roykollensvendsen/garage-door/docs/openers/lm100evf.md

<!-- SPDX-License-Identifier: GPL-3.0-or-later -->
<!-- Generated by scripts/openers.py from hardware/openers/. Do not edit. -->

# LiftMaster LM100EVF

**Status:** Expected to work, not tried yet.

| | |
|---|---|
| Brand and model | LiftMaster LM100EVF |
| Also sold as | none known |
| Region | EU |
| Manual | Assembly and operating instructions, LM60EVF/LM80EVF/LM100EVF/LM130EVF, document 114A4C095B ([download](https://ismartgate.com/manuals/Chamberlain_LM80EVF_manual.pdf)) |
| Push-button terminals | **1 and 2** (manual PDF p. 269, fig. 19-20 (one manual and terminal block for all four models)) |
| Voltage across them, open | not measured yet |
| Reported by | nobody yet |
| A build | none yet |

## Checked on a real opener

- Nothing yet.

## Leave alone

- The wire bridge on terminals 4 and 5 (manual PDF p. 22, section 26 A).

## Notes

Shares the LM80EVF's manual and terminal block, so the same wiring is expected to work. Nobody has tried it yet: if you do, change the status and add your name.

Source: [`hardware/openers/lm100evf.yaml`](https://github.com/roykollensvendsen/garage-door/blob/main/hardware/openers/lm100evf.yaml).
To correct it, edit that file; see [Add your opener](../compatibility.md#add-your-opener).
