roykollensvendsen/garage-door/docs/compatibility.md

<!-- SPDX-License-Identifier: GPL-3.0-or-later -->
<!-- Generated by scripts/openers.py from hardware/openers/. Do not edit. -->

# Does it work with your opener?

The controller needs one thing from an opener: a **wall push-button input**
that starts, stops and reverses the door when two terminals are briefly joined.
Most garage door openers have one. These are the models we know about.

| Opener | Region | Push-button terminals | Status |
|---|---|---|---|
| [LiftMaster LM100EVF](openers/lm100evf.md) | EU | 1 and 2 | Expected to work, not tried yet |
| [LiftMaster LM130EVF](openers/lm130evf.md) | EU | 1 and 2 | Expected to work, not tried yet |
| [LiftMaster LM60EVF](openers/lm60evf.md) | EU | 1 and 2 | Expected to work, not tried yet |
| [LiftMaster LM80EVF](openers/lm80evf.md) | EU | 1 and 2 | Works: built and used on a real door |

"Expected to work" means the manual shows the same push-button input, but
nobody has built the controller for that model yet. Be the first, and tell us.

## Add your opener

Adding your opener is the easiest way to contribute, and the most useful.

1. Find your opener's manual and the page that shows the wall push-button
   terminals.
2. Copy [`hardware/openers/_template.yaml`](https://github.com/roykollensvendsen/garage-door/blob/main/hardware/openers/_template.yaml)
   to `hardware/openers/<model>.yaml` and fill it in. Cite a manual page for
   every terminal, and never copy the manual's text.
3. Run `just docs` to see your page, and open a pull request.

Not sure? [Open an "add my opener" issue](https://github.com/roykollensvendsen/garage-door/issues/new?template=add-opener-model.yml)
with the model and a photo of the terminal block, and we will help. A coding
agent can do it with the project skill `add-opener-model`.
