roykollensvendsen/garage-door/docs/assets/social-preview.png

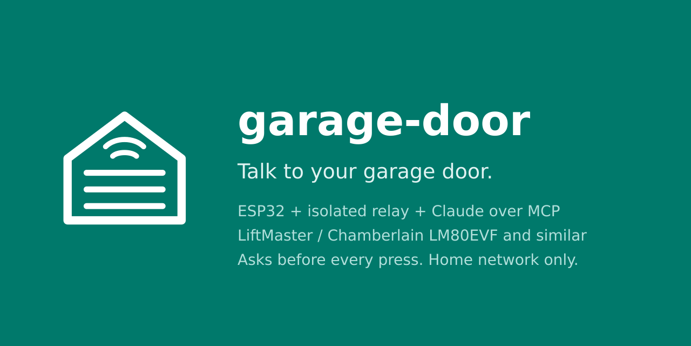
docs/assets/social-preview.png
