roykollensvendsen/garage-door/docs/wiring/schematic.pdf

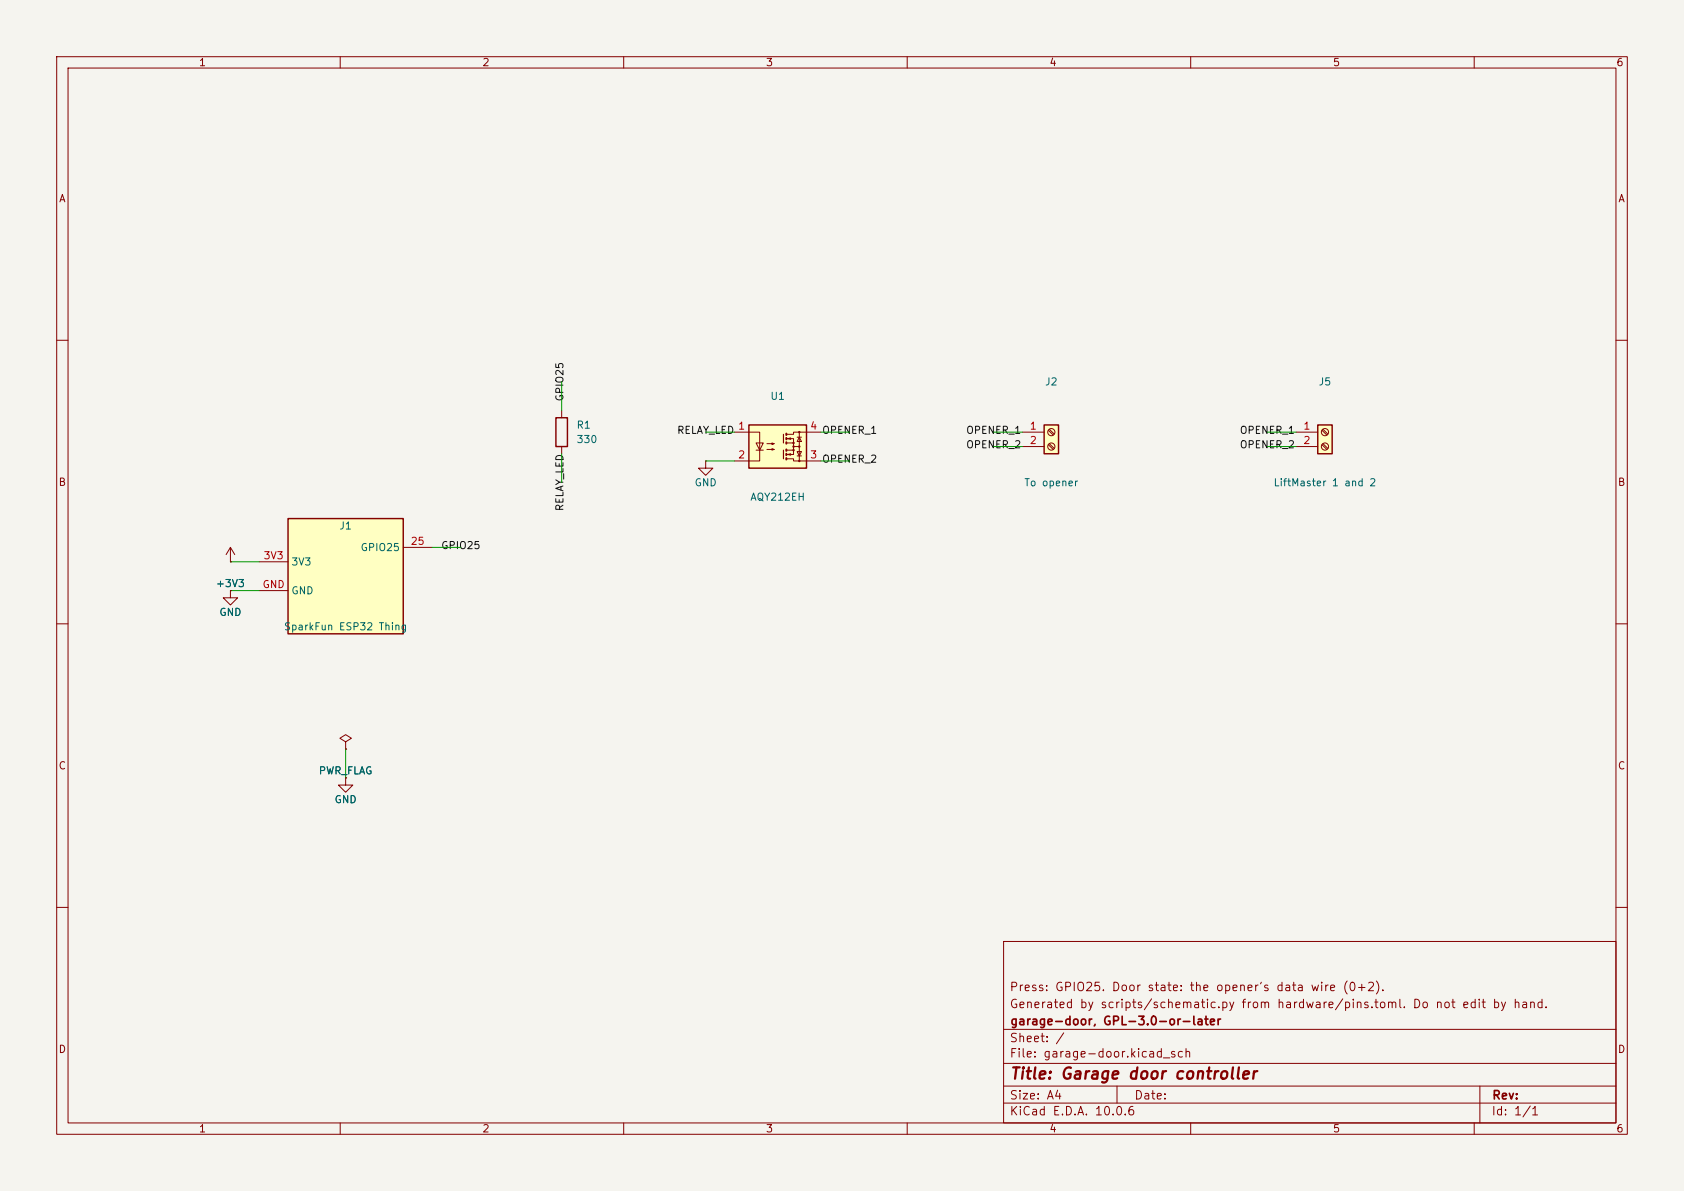
[picture p2: page 1]

Press: GPIO25. Door state: the opener's data wire (0+2).
Generated by scripts/schematic.py from hardware/pins.toml. Do not edit by hand.
garage-door, GPL-3.0-or-later
Sheet: /
File: garage-door.kicad_sch
Title: Garage door controller

Size: A4 | Rev:
KiCad E.D.A. 10.0.6 | Id: 1/1
