roykollensvendsen/garage-door/hardware/garage-door.kicad_sch

## KiCad design hardware/garage-door.kicad_sch (2026-11-06)

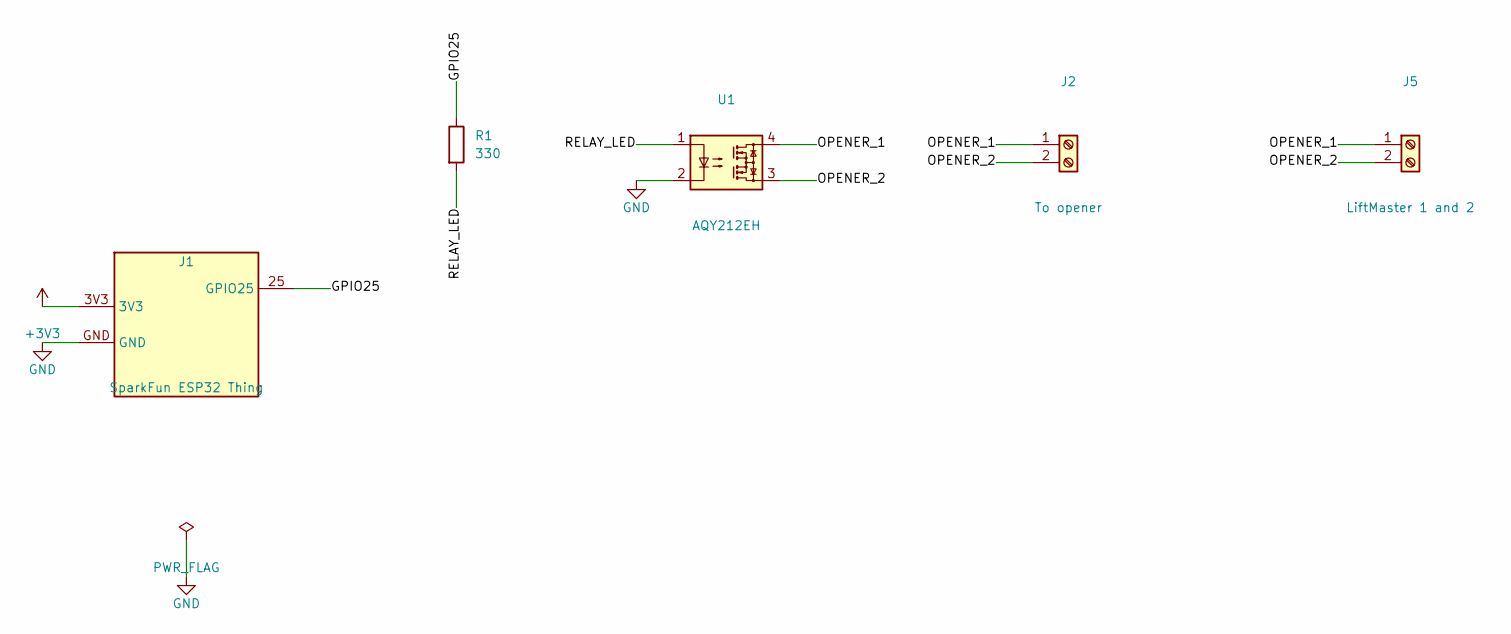
[picture p3: schematic garage-door.kicad_sch]

Parts:
J1: SparkFun ESP32 Thing
J2: To opener
J5: LiftMaster 1 and 2
R1: 330
U1: AQY212EH

Connections:
+3V3: J1.3V3
GND: J1.GND, U1.2
GPIO25: J1.25 (GPIO25), R1.1
OPENER_1: J2.1, J5.1, U1.4
OPENER_2: J2.2, J5.2, U1.3
RELAY_LED: R1.2, U1.1
