roykollensvendsen/garage-door/hardware/harness.yaml

# SPDX-License-Identifier: GPL-3.0-or-later
#
# The cables between the controller box and the garage: which terminal, which
# wire colour, where it ends. Rendered with WireViz by scripts/render-diagrams.sh
# into docs/wiring/. The GPIO numbers and opener terminals must match
# hardware/pins.toml; tests/test_hardware.py checks that they do.
#
# Inside the box, the board is wired as the schematic shows
# (hardware/garage-door.kicad_sch); nothing here runs inside the opener except
# the two wires into its terminals 1 and 2. The door state comes from the
# opener's data wire (0+2, docs/plan.md); there are no reed contacts.

metadata:
  title: Garage door controller, field wiring

options:
  fontname: DejaVu Sans
  bgcolor: WH

connectors:
  J2:
    type: Box terminal, 2-pin screw
    subtype: relay output (AQY212EH, isolated)
    pinlabels: [OPENER_1, OPENER_2]
    notes: Isolated from the controller. Polarity does not matter.
  OPENER:
    type: LiftMaster LM80EVF terminal block
    subtype: push-in spring terminals
    pins: [1, 2]
    pinlabels: [push button, common]
    notes: Unplug the opener first. Use only 1 and 2. Leave the 4-5 bridge in place.

cables:
  W1:
    type: Bell wire, 2-core
    gauge: 0.5 mm2
    length: 1
    colors: [WH, RD]

connections:
  - - J2: [1, 2]
    - W1: [1, 2]
    - OPENER: [1, 2]
