roykollensvendsen/garage-door/tests/test_hardware.py

# SPDX-License-Identifier: GPL-3.0-or-later
"""The wiring is decided once, in hardware/pins.toml, and everything else agrees with it.

The firmware, the schematic, the wiring diagram and the pictures in the docs
are each checked against the pin plan, so a pin changed in one place and not
the others fails here instead of at the garage.
"""

from __future__ import annotations

import importlib.util
import pathlib
import re
import sys
import tomllib

import yaml

ROOT = pathlib.Path(__file__).parent.parent
PLAN = tomllib.loads((ROOT / "hardware/pins.toml").read_text())
GPIO = PLAN["gpio"]


def _script(name: str):
    spec = importlib.util.spec_from_file_location(name, ROOT / f"scripts/{name}.py")
    assert spec
    assert spec.loader
    module = importlib.util.module_from_spec(spec)
    sys.modules[name] = module  # dataclasses look their module up here
    spec.loader.exec_module(module)
    return module


class _Secret(str):
    """Stands in for ESPHome's `!secret` values, which these tests never need."""

    __slots__ = ()


def _esphome_config() -> dict:
    loader = type("Loader", (yaml.SafeLoader,), {})
    loader.add_constructor("!secret", lambda _loader, node: _Secret(node.value))
    return yaml.load((ROOT / "firmware/garage-door.yaml").read_text(), Loader=loader)  # noqa: S506


def test_the_firmware_uses_the_planned_pins():
    config = _esphome_config()
    outputs = {o["id"]: o["pin"]["number"] for o in config["output"]}
    assert outputs["press_output"] == f"GPIO{GPIO['press']}"


def test_the_firmware_listens_on_the_planned_wire_pin_and_never_sends_on_it():
    # Sending on the opener's wire waits for Roy's approval (decisions/ADR-GD-003).
    # The wire's UART is set up with ESP-IDF itself (door_logic/wire_uart.h), to
    # count framing errors and overflows; ESPHome's uart component is not used.
    config = _esphome_config()
    assert "uart" not in config
    assert config["substitutions"]["wire_rx_gpio"] == str(GPIO["wire_rx"])
    assert "begin(${wire_rx_gpio}," in str(config["esphome"]["on_boot"])
    assert "wire_speed().baud()" in str(config["esphome"]["on_boot"])
    glue = (ROOT / "firmware/door_logic/wire_uart.h").read_text()
    assert "uart_set_pin(kPort, UART_PIN_NO_CHANGE, rx_gpio, UART_PIN_NO_CHANGE, UART_PIN_NO_CHANGE)" in glue
    assert "uart_write" not in glue
    assert "uart_set_baudrate(kPort, baud)" in glue  # the speed changes; the pins never do
    assert "uart_tx" not in glue
    assert "door_logic/wire_uart.h" in config["esphome"]["includes"]
    assert 34 <= GPIO["wire_rx"] <= 39, "an input-only pin cannot drive the opener's bus by mistake"


WIRE_HEALTH = {
    "Wire bytes received",
    "Wire bytes skipped",
    "Wire packets decoded",
    "Wire packets failed",
    "Wire rolling-code gaps",
    "Wire framing errors",
    "Wire parity errors",
    "Wire overflows",
    "Wire breaks",
}


def test_the_wire_health_counters_are_reported_over_the_api():
    names = {s.get("name") for s in _esphome_config()["sensor"]}
    assert names >= WIRE_HEALTH


def test_the_controller_starts_unarmed_after_every_boot():
    switches = {s["id"]: s for s in _esphome_config()["switch"]}
    assert switches["armed"]["restore_mode"] == "ALWAYS_OFF"


def test_the_door_state_comes_only_from_the_opener_wire():
    # Roy, 2026-11-06: no reed contacts. The opener's own status on 0+2 is the
    # only source; door_logic.h keeps its tested reed logic for anyone who adds them.
    config = _esphome_config()
    assert "binary_sensor" not in config
    assert "state_from" not in config["substitutions"]
    assert "door.update(" not in str(config)
    assert "door.update_from_wire(" in str(config)
    assert not {"sensor_closed", "sensor_open"} & set(GPIO)


def test_the_press_pin_is_not_a_strapping_pin():
    # 0, 2, 12 and 15 decide how the chip boots; driving them can stop it starting.
    assert GPIO["press"] not in {0, 2, 12, 15}
    assert GPIO["press"] < 34, "34-39 are input-only and cannot drive the relay"


def test_the_schematic_is_generated_from_the_current_pin_plan():
    schematic = _script("schematic")
    for path, text in schematic.outputs(PLAN).items():
        assert path.read_text() == text, f"{path.name} is stale: run python scripts/schematic.py"


def test_the_schematic_connects_the_planned_pins():
    schematic = _script("schematic")
    nets = {}
    for part in schematic.parts_from(PLAN):
        for pin, net in part.nets.items():
            nets.setdefault(net, set()).add(f"{part.reference}.{pin}")
    assert f"J1.{GPIO['press']}" in nets[f"GPIO{GPIO['press']}"]
    assert nets["OPENER_1"] >= {"U1.4", "J5.1"}
    assert nets["OPENER_2"] >= {"U1.3", "J5.2"}
    # The opener side touches only the relay's isolated output, nothing else.
    assert {n.split(".")[0] for n in nets["OPENER_1"] | nets["OPENER_2"]} == {"U1", "J2", "J5"}


def test_the_wiring_diagram_names_the_planned_pins_and_terminals():
    harness = yaml.safe_load((ROOT / "hardware/harness.yaml").read_text())
    connectors = harness["connectors"]
    assert connectors["OPENER"]["pins"] == PLAN["opener"]["terminals"]
    assert not {"J3", "J4"} & set(connectors), "no reed contacts"
    assert "4-5 bridge" in connectors["OPENER"]["notes"]


def test_the_pictures_were_rendered_from_the_current_sources():
    recorded = (ROOT / "docs/wiring/sources.sha256").read_text()
    assert recorded == _script("diagram_sources").manifest(), (
        "a wiring source changed since the pictures were drawn: run sh scripts/render-diagrams.sh"
    )


def test_every_picture_the_docs_show_exists():
    for page in (ROOT / "docs").rglob("*.md"):
        for target in re.findall(r"!\[[^\]]*\]\(([^)]+)\)", page.read_text()):
            if not target.startswith("http"):
                assert (page.parent / target).exists(), f"{page.name} shows a missing picture: {target}"


def test_the_relay_polarity_is_set_in_one_place_and_defaults_to_active_high():
    # Roy's first-test relay module may trigger on a low input (2026-11-04). The
    # level is one substitution, so "off" means relay open whichever module is
    # fitted; the bench check in the build guide decides it before the opener.
    raw = _esphome_config()
    assert raw["substitutions"]["relay_active_low"] == "false"
    press = next(o for o in raw["output"] if o["id"] == "press_output")
    assert press["pin"] == {"number": f"GPIO{GPIO['press']}", "inverted": "${relay_active_low}"}


def test_the_press_output_never_restores_an_on_state():
    # A gpio output starts off at boot; nothing may hold it on across a restart.
    press = next(o for o in _esphome_config()["output"] if o["id"] == "press_output")
    assert "restore_mode" not in press
    assert "power_supply" not in press


def test_ota_updates_use_the_api_key_not_a_second_one():
    # ESPHome 2026.10 refuses an OTA key that differs from the API key; the
    # example secrets used one key for both, so CI never saw it (Roy's flash).
    ota = _esphome_config()["ota"][0]
    assert "encryption" not in ota
    assert "ota_encryption_key" not in (ROOT / "firmware/secrets.example.yaml").read_text()


def test_manual_mode_is_off_after_every_boot_and_has_its_own_press_action():
    # decisions/ADR-GD-004: the manual press is a separate action, allowed only
    # while the "Manual mode" switch is on, and that switch never survives a boot.
    config = _esphome_config()
    switches = {s["id"]: s for s in config["switch"]}
    assert switches["manual"]["restore_mode"] == "ALWAYS_OFF"
    assert switches["manual"]["name"] == "Manual mode"
    actions = {a["action"]: a for a in config["api"]["actions"]}
    assert "request_manual_press(millis())" in actions["manual_press"]["then"][0]["lambda"]
    assert "request_manual_press" not in actions["press"]["then"][0]["lambda"]


def test_the_door_state_from_the_wire_trusts_the_last_status_by_default():
    # decisions/ADR-GD-005: both ways selectable, "last_status" the default for now.
    config = _esphome_config()
    assert config["substitutions"]["wire_trust"] == "last_status"
    glue = (ROOT / "firmware/door_logic/esphome_glue.h").read_text()
    assert 'c.trust_last_status = std::string(wire_trust) == "last_status";' in glue


def test_the_opener_light_and_the_age_of_its_last_status_are_reported_read_only():
    config = _esphome_config()
    texts = {t.get("name"): t for t in config["text_sensor"]}
    sensors = {t.get("name"): t for t in config["sensor"]}
    assert "Opener light" in texts
    assert "Opener status age" in sensors
    yaml_text = (ROOT / "firmware/garage-door.yaml").read_text()
    assert 'id(opener_light).publish_state(s.light ? "on" : "off");' in yaml_text
    assert "light" not in {s.get("name", "").lower() for s in config["switch"]}  # nothing switches the light
