roykollensvendsen/garage-door/tests/test_server.py

# SPDX-License-Identifier: GPL-3.0-or-later
"""The MCP tools a voice session calls, driven through the MCP server itself."""

from __future__ import annotations

import asyncio
from typing import TYPE_CHECKING

import pytest
from mcp.server.mcpserver.exceptions import ToolError

from garage_door.door import DoorState
from garage_door.manual import ManualPress
from garage_door.server import build_server, settings_from
from garage_door.service import GarageService
from garage_door.switches import Switches

if TYPE_CHECKING:
    import pathlib


class FakeDevice:
    def __init__(
        self,
        state: DoorState,
        after_press: DoorState,
        *,
        armed: bool | None = True,
        manual: bool | None = False,
    ) -> None:
        self.current = state
        self.after_press = after_press
        self.is_armed = armed
        self.is_manual = manual
        self.presses = 0
        self.manual_presses = 0

    async def manual(self) -> bool | None:
        return self.is_manual

    async def set_armed(self, *, on: bool) -> None:
        self.is_armed = on

    async def set_manual(self, *, on: bool) -> None:
        self.is_manual = on

    async def manual_press(self) -> str:
        self.manual_presses += 1
        return "manual: accepted"

    async def state(self) -> DoorState:
        return self.current

    async def armed(self) -> bool | None:
        return self.is_armed

    async def press(self) -> str:
        self.presses += 1
        self.current = self.after_press
        return "accepted"


async def _no_wait(_seconds: float) -> None:
    return None


def server_for(device: FakeDevice, tmp_path: pathlib.Path):
    service = GarageService(device, log_path=tmp_path / "presses.jsonl", sleep=_no_wait)
    log = tmp_path / "presses.jsonl"
    return build_server(service, ManualPress(device, log_path=log), Switches(device, log_path=log))


def call(server, tool: str, arguments: dict[str, object]) -> dict[str, object]:
    result = asyncio.run(server.call_tool(tool, arguments))
    assert not result.is_error
    return result.structured_content


class GoesAfterThePress(FakeDevice):
    """A controller whose link goes once the door has arrived: every later read waits on a reconnect."""

    reads_after_press = 0

    async def state(self) -> DoorState:
        if self.presses:
            self.reads_after_press += 1
        if self.reads_after_press > 1:  # the first tells the service the door arrived
            await asyncio.Event().wait()  # a reconnect, which can take connect_wait + first_state_wait
        return await super().state()


def test_the_report_after_a_press_is_given_up_on_rather_than_waited_for(tmp_path, monkeypatch):
    # After the press, the answer is ready. Reconnecting for the report could
    # add 8 s more and push the answer past the voice's limit; give it a moment.
    device = GoesAfterThePress(DoorState.CLOSED, DoorState.OPEN)
    log = tmp_path / "presses.jsonl"
    service = GarageService(device, log_path=log, sleep=_no_wait)
    monkeypatch.setattr("garage_door.manual.REPORT_SECONDS", 0.05)
    manual = ManualPress(device, log_path=log)
    server = build_server(service, manual, Switches(device, log_path=log))
    question = call(server, "garage_request", {"action": "open"})

    async def confirm() -> object:
        return await asyncio.wait_for(server.call_tool("garage_confirm", {"token": question["token"]}), 2.0)

    answer = asyncio.run(confirm()).structured_content
    assert device.presses == 1
    assert answer["controller"]["state"] == "unknown"


def test_the_server_offers_exactly_status_request_confirm_the_manual_press_and_switching(tmp_path):
    server = server_for(FakeDevice(DoorState.CLOSED, DoorState.OPEN), tmp_path)
    tools = {tool.name: tool for tool in asyncio.run(server.list_tools())}
    assert set(tools) == {
        "garage_status",
        "garage_request",
        "garage_confirm",
        "garage_press_button",
        "garage_switch",
    }
    assert tools["garage_switch"].input_schema["properties"]["change"]["enum"] == [
        "arm",
        "disarm",
        "manual_on",
        "manual_off",
    ]
    assert "spoken yes" in tools["garage_confirm"].description
    assert tools["garage_request"].input_schema["properties"]["action"]["enum"] == ["open", "close"]


def test_status_reports_the_door(tmp_path):
    server = server_for(FakeDevice(DoorState.CLOSED, DoorState.OPEN), tmp_path)
    answer = call(server, "garage_status", {})
    assert (answer["state"], answer["armed"]) == ("closed", True)


@pytest.mark.parametrize("armed", [False, None])
def test_status_says_when_the_controller_is_in_test_mode_or_not_known(tmp_path, armed):
    server = server_for(FakeDevice(DoorState.CLOSED, DoorState.OPEN, armed=armed), tmp_path)
    answer = call(server, "garage_status", {})
    assert (answer["state"], answer["armed"]) == ("closed", armed)


def test_a_press_in_test_mode_comes_back_as_test_mode(tmp_path):
    device = FakeDevice(DoorState.CLOSED, DoorState.CLOSED, armed=False)
    server = server_for(device, tmp_path)
    asked = call(server, "garage_request", {"action": "open"})
    done = call(server, "garage_confirm", {"token": asked["token"]})
    assert done["outcome"] == "pressed"
    assert done["armed"] is False
    assert done["say"].startswith("Test mode:")


def test_request_then_confirm_presses_once_through_the_tools(tmp_path):
    device = FakeDevice(DoorState.CLOSED, DoorState.OPEN)
    server = server_for(device, tmp_path)
    asked = call(server, "garage_request", {"action": "open"})
    assert asked["outcome"] == "question"
    assert asked["say"] == "The garage door is closed. Do you want me to open it?"
    assert device.presses == 0
    done = call(server, "garage_confirm", {"token": asked["token"]})
    assert done["outcome"] == "pressed"
    assert (done["before"], done["after"]) == ("closed", "open")
    assert done["armed"] is True
    assert device.presses == 1


def test_a_refusal_comes_back_as_something_to_say(tmp_path):
    device = FakeDevice(DoorState.MOVING, DoorState.OPEN)
    server = server_for(device, tmp_path)
    refused = call(server, "garage_request", {"action": "open"})
    assert {k: v for k, v in refused.items() if k != "controller"} == {
        "outcome": "refused",
        "state": "moving",
        "say": (
            "The garage door is moving, so I won't press. Wait until it stops, then ask again; "
            "if it stays like this, check the controller's power and Wi-Fi."
        ),
    }


def test_an_action_other_than_open_or_close_is_rejected(tmp_path):
    device = FakeDevice(DoorState.CLOSED, DoorState.OPEN)
    server = server_for(device, tmp_path)
    with pytest.raises(ToolError):
        asyncio.run(server.call_tool("garage_request", {"action": "sideways"}))
    assert device.presses == 0


# --- Settings ----------------------------------------------------------------


def test_settings_need_the_controllers_address_and_key():
    with pytest.raises(SystemExit, match="GARAGE_DOOR_HOST"):
        settings_from({"GARAGE_DOOR_API_KEY": "k"})
    with pytest.raises(SystemExit, match="GARAGE_DOOR_API_KEY"):
        settings_from({"GARAGE_DOOR_HOST": "garage-door.local"})


def test_the_key_and_address_can_come_from_the_secrets_file_and_a_flag(tmp_path):
    # So a launcher (the claude-voice bridge) never holds the key.
    secrets = tmp_path / "secrets.yaml"
    secrets.write_text('wifi_ssid: "home"\napi_encryption_key: "from-the-file="\n')
    settings = settings_from({}, secrets_file=secrets, host="192.0.2.7")
    assert (settings.host, settings.api_key) == ("192.0.2.7", "from-the-file=")
    env = {"GARAGE_DOOR_HOST": "garage-door.local", "GARAGE_DOOR_API_KEY": "from-env"}
    settings = settings_from(env, secrets_file=secrets, host="192.0.2.7")
    assert (settings.host, settings.api_key) == ("garage-door.local", "from-env")  # the environment wins


def test_a_secrets_file_without_the_key_refuses_to_start(tmp_path):
    secrets = tmp_path / "secrets.yaml"
    secrets.write_text('wifi_ssid: "home"\n')
    with pytest.raises(SystemExit, match="api_encryption_key"):
        settings_from({}, secrets_file=secrets, host="192.0.2.7")
    with pytest.raises(SystemExit, match="cannot read"):
        settings_from({}, secrets_file=tmp_path / "missing.yaml", host="192.0.2.7")


def test_closing_is_on_unless_the_setting_says_no():
    base = {"GARAGE_DOOR_HOST": "garage-door.local", "GARAGE_DOOR_API_KEY": "k"}
    assert settings_from(base).allow_close is True
    assert settings_from({**base, "GARAGE_DOOR_ALLOW_CLOSE": "no"}).allow_close is False


def test_the_log_goes_under_the_users_state_folder_by_default():
    settings = settings_from(
        {"GARAGE_DOOR_HOST": "h", "GARAGE_DOOR_API_KEY": "k", "XDG_STATE_HOME": "/state"}
    )
    assert str(settings.log_path) == "/state/garage-door/presses.jsonl"


def test_the_simulated_server_says_it_is_simulated_and_logs_apart(tmp_path):
    from garage_door.server import simulated_service  # noqa: PLC0415
    from garage_door.simulator import Start  # noqa: PLC0415

    services = simulated_service({"XDG_STATE_HOME": str(tmp_path)}, Start.CLOSED)
    server = build_server(*services, simulated=True)
    assert server.name == "garage-door-simulated"
    assert server.instructions.startswith("SIMULATED:")
    answer = call(server, "garage_status", {})
    assert (answer["state"], answer["armed"]) == ("closed", True)
    asked = call(server, "garage_request", {"action": "open"})
    assert asked["outcome"] == "question"
    assert (tmp_path / "garage-door/simulated.jsonl").exists()
    assert not (tmp_path / "garage-door/presses.jsonl").exists()


def test_a_confirm_with_a_wrong_token_is_refused_through_the_tools(tmp_path):
    device = FakeDevice(DoorState.CLOSED, DoorState.OPEN)
    server = server_for(device, tmp_path)
    call(server, "garage_request", {"action": "open"})
    refused = call(server, "garage_confirm", {"token": "not-the-token"})
    assert refused["outcome"] == "refused"
    assert device.presses == 0


# --- Manual press (decisions/ADR-GD-004) and what the controller says ---------------


def test_every_answer_says_what_the_controller_reports(tmp_path):
    device = FakeDevice(DoorState.CLOSED, DoorState.OPEN)
    server = server_for(device, tmp_path)
    report = {
        "state": "closed",
        "state_trusted": True,
        "armed": True,
        "manual": False,
        "light": None,
        "light_reported_s_ago": None,
    }
    assert call(server, "garage_status", {})["controller"] == report
    assert call(server, "garage_status", {})["say"] == "The garage door is closed."
    question = call(server, "garage_request", {"action": "open"})
    assert question["controller"] == report
    assert call(server, "garage_confirm", {"token": question["token"]})["controller"]["state"] == "open"
    assert call(server, "garage_press_button", {})["controller"] == {**report, "state": "open"}


def test_the_manual_press_says_not_armed_instead_of_asking(tmp_path):
    server = server_for(FakeDevice(DoorState.UNKNOWN, DoorState.UNKNOWN, armed=False, manual=True), tmp_path)
    answer = call(server, "garage_press_button", {})
    assert answer["outcome"] == "refused"
    assert answer["say"].startswith("The controller is not armed")
    assert "token" not in answer


def test_the_manual_press_asks_names_no_direction_and_presses_once_on_confirm(tmp_path):
    device = FakeDevice(DoorState.UNKNOWN, DoorState.UNKNOWN, manual=True)
    server = server_for(device, tmp_path)
    question = call(server, "garage_press_button", {})
    assert question["outcome"] == "question"
    assert "Only say yes if you can see the door." in question["say"]
    assert question["controller"]["manual"] is True
    pressed = call(server, "garage_confirm", {"token": question["token"]})
    assert pressed["outcome"] == "pressed"
    assert pressed["say"].startswith("Pressed. I can't tell which way")
    assert "reached" not in pressed
    assert (device.manual_presses, device.presses) == (1, 0)


def test_an_ordinary_request_still_refuses_an_unknown_door_in_manual_mode(tmp_path):
    device = FakeDevice(DoorState.UNKNOWN, DoorState.OPEN, manual=True)
    answer = call(server_for(device, tmp_path), "garage_request", {"action": "open"})
    assert answer["outcome"] == "refused"
    assert device.presses == 0


def test_a_manual_confirm_after_manual_mode_ended_is_refused(tmp_path):
    device = FakeDevice(DoorState.UNKNOWN, DoorState.UNKNOWN, manual=True)
    server = server_for(device, tmp_path)
    question = call(server, "garage_press_button", {})
    device.is_manual = False
    answer = call(server, "garage_confirm", {"token": question["token"]})
    assert answer["outcome"] == "refused"
    assert answer["controller"]["manual"] is False
    assert device.manual_presses == 0


def test_arming_by_voice_asks_and_arms_only_on_confirm(tmp_path):
    # decisions/ADR-GD-006
    device = FakeDevice(DoorState.CLOSED, DoorState.OPEN, armed=False)
    server = server_for(device, tmp_path)
    asked = call(server, "garage_switch", {"change": "arm"})
    assert asked["outcome"] == "question"
    assert asked["say"].startswith("The controller is not armed. Do you want me to arm it")
    assert device.is_armed is False
    done = call(server, "garage_confirm", {"token": asked["token"]})
    assert done["outcome"] == "switched"
    assert device.is_armed is True
    assert done["controller"]["armed"] is True


def test_disarming_and_manual_off_by_voice_happen_at_once(tmp_path):
    device = FakeDevice(DoorState.CLOSED, DoorState.OPEN, armed=True, manual=True)
    server = server_for(device, tmp_path)
    assert call(server, "garage_switch", {"change": "manual_off"})["outcome"] == "switched"
    assert call(server, "garage_switch", {"change": "disarm"})["outcome"] == "switched"
    assert (device.is_armed, device.is_manual) == (False, False)


def test_a_switch_token_does_not_press_and_a_press_token_does_not_switch(tmp_path):
    device = FakeDevice(DoorState.CLOSED, DoorState.OPEN, armed=False)
    server = server_for(device, tmp_path)
    asked = call(server, "garage_switch", {"change": "arm"})
    call(server, "garage_confirm", {"token": asked["token"]})
    assert device.presses == 0
    press = call(server, "garage_request", {"action": "open"})
    device.is_armed = False
    refused = call(server, "garage_confirm", {"token": "not-a-token"})
    assert refused["outcome"] == "refused"
    assert device.is_armed is False
    assert press["outcome"] == "question"


def test_the_simulated_door_cannot_be_switched(tmp_path):
    from garage_door.server import simulated_service  # noqa: PLC0415
    from garage_door.simulator import Start  # noqa: PLC0415

    services = simulated_service({"XDG_STATE_HOME": str(tmp_path)}, Start.CLOSED)
    server = build_server(*services, simulated=True)
    answer = call(server, "garage_switch", {"change": "arm"})
    assert answer["outcome"] == "refused"
    assert "simulated" in answer["say"]


def test_the_voice_is_told_to_keep_one_question_open_and_confirm_the_newest_token(tmp_path):
    # 2026-11-05 14:38: two requests 3 s apart, then a confirm with the first token, refused.
    from garage_door.server import INSTRUCTIONS  # noqa: PLC0415

    assert "Never call garage_request again while a question is open" in INSTRUCTIONS
    server = server_for(FakeDevice(DoorState.CLOSED, DoorState.OPEN), tmp_path)
    tools = {tool.name: tool for tool in asyncio.run(server.list_tools())}
    assert "most recent" in tools["garage_confirm"].description
    assert "cancels the question" in tools["garage_confirm"].description


def test_a_magic_phrase_through_the_tool_presses_without_a_question(tmp_path):
    # decisions/ADR-GD-008
    from garage_door.phrases import Phrases  # noqa: PLC0415

    device = FakeDevice(DoorState.CLOSED, DoorState.OPEN)
    log = tmp_path / "presses.jsonl"
    phrases = Phrases.from_table({"nb": {"open": ["sesam lukk deg opp"]}})
    service = GarageService(device, log_path=log, sleep=_no_wait, phrases=phrases)
    server = build_server(service, ManualPress(device, log_path=log), Switches(device, log_path=log))
    answer = call(server, "garage_request", {"action": "open", "phrase": "sesam, lukk deg opp"})
    assert answer["outcome"] == "pressed"
    assert device.presses == 1
    assert answer["say"] == "Pressed. The garage door was closed and is now open."


def test_the_phrase_is_optional_and_the_voice_is_told_never_to_make_it_up(tmp_path):
    from garage_door.server import INSTRUCTIONS  # noqa: PLC0415

    server = server_for(FakeDevice(DoorState.CLOSED, DoorState.OPEN), tmp_path)
    tools = {tool.name: tool for tool in asyncio.run(server.list_tools())}
    schema = tools["garage_request"].input_schema
    assert "phrase" in schema["properties"]
    assert schema["required"] == ["action"]
    for text in (INSTRUCTIONS, tools["garage_request"].description):
        assert "exactly as Roy said them" in text
        assert "never" in text.lower()


def test_the_phrase_file_comes_from_the_users_config_folder_or_the_setting(tmp_path):
    base = {"GARAGE_DOOR_HOST": "garage-door.local", "GARAGE_DOOR_API_KEY": "k"}
    assert settings_from({**base, "XDG_CONFIG_HOME": str(tmp_path)}).phrases_path == (
        tmp_path / "garage-door" / "phrases.toml"
    )
    chosen = tmp_path / "mine.toml"
    assert settings_from({**base, "GARAGE_DOOR_PHRASES": str(chosen)}).phrases_path == chosen


SHORT_OPENING = 26  # the voice app shows only about 26 characters of an unloaded tool (claude-voice)


def test_each_tool_opens_with_a_short_whole_sentence_of_its_own(tmp_path):
    # claude-voice, 2026-11-10: the app cuts each unloaded tool's line, so the
    # first sentence must say on its own what sets the tool apart.
    server = server_for(FakeDevice(DoorState.CLOSED, DoorState.OPEN), tmp_path)
    tools = asyncio.run(server.list_tools())
    openings = {tool.name: tool.description.split("\n", 1) for tool in tools}
    for name, (first, *rest) in openings.items():
        assert first.endswith("."), f"{name}: the first line is not a whole sentence"
        assert first.count(". ") == 0, f"{name}: the first line holds more than one sentence"
        assert len(first) <= SHORT_OPENING, f"{name}: {first!r} is too long"
        assert rest, f"{name}: the details belong on the next lines"
    first_words = [first.split()[0].strip(",:;").casefold() for first, *_ in openings.values()]
    assert len(set(first_words)) == len(first_words), "two tools open with the same word"


def test_a_switch_the_controller_never_received_is_read_out_as_refused(tmp_path):
    from garage_door.door import DeviceUnavailableError  # noqa: PLC0415

    class Unreachable(FakeDevice):
        async def set_armed(self, *, on: bool) -> None:  # noqa: ARG002 - fails whatever it is asked
            raise DeviceUnavailableError

    server = server_for(Unreachable(DoorState.CLOSED, DoorState.OPEN, armed=True), tmp_path)
    answer = call(server, "garage_switch", {"change": "disarm"})
    assert answer["outcome"] == "refused"
    assert answer["say"]


def test_only_the_status_tool_is_marked_read_only(tmp_path):
    # claude-voice docs/plugin-standard.md, rule 9: a tool that changes nothing says so.
    server = server_for(FakeDevice(DoorState.CLOSED, DoorState.OPEN), tmp_path)
    tools = {tool.name: tool for tool in asyncio.run(server.list_tools())}
    read_only = {name for name, tool in tools.items() if tool.annotations and tool.annotations.read_only_hint}
    assert read_only == {"garage_status"}


def test_every_answer_from_the_simulated_door_says_so_first(tmp_path):
    # claude-voice docs/plugin-standard.md, rule 11: a pretend door is never taken for the real one.
    from garage_door.server import simulated_service  # noqa: PLC0415
    from garage_door.simulator import Start  # noqa: PLC0415

    server = build_server(*simulated_service({"XDG_STATE_HOME": str(tmp_path)}, Start.CLOSED), simulated=True)
    asked = call(server, "garage_request", {"action": "open"})
    answers = [
        call(server, "garage_status", {}),
        asked,
        call(server, "garage_confirm", {"token": "not-the-token"}),  # a real press takes the door's time
        call(server, "garage_press_button", {}),
        call(server, "garage_switch", {"change": "arm"}),
    ]
    for answer in answers:
        assert answer["simulated"] is True
        assert answer["say"].startswith("Simulated: ")


def test_answers_from_the_real_door_do_not_say_simulated(tmp_path):
    server = server_for(FakeDevice(DoorState.CLOSED, DoorState.OPEN), tmp_path)
    answer = call(server, "garage_request", {"action": "open"})
    assert "simulated" not in answer
    assert not answer["say"].startswith("Simulated")
