roykollensvendsen/garage-door/tests/test_rules_have_evidence.py

# SPDX-License-Identifier: GPL-3.0-or-later
"""Every rule this project enforces has evidence, and the evidence names it.

A rule here is one line of source marked ``# RULE: what it says``. Three things
have to be true of each, and none of them is true by writing the rule:

* it has a row in ``scripts/mutations.toml``, so something switches it off;
* a test carries the rule's own words as its name;
* switching it off turns *that* test red, which ``scripts/mutate.py`` checks.

The second is what makes the third readable. A mutation breaks whatever it
breaks, and a kill only means something when the test that went red is the one
that names the rule — otherwise a documented example that happened to change can
leave a rule looking guarded while nothing guards it.
"""

import importlib.util
import pathlib
import re
import tomllib

ROOT = pathlib.Path(__file__).parent.parent
MARKER = re.compile(r"^[ \t]*#\s*RULE:\s*(.+?)\s*$")


def _mutate():
    """The mutation runner, loaded by path: scripts/ is not a package."""
    spec = importlib.util.spec_from_file_location("mutate", ROOT / "scripts/mutate.py")
    module = importlib.util.module_from_spec(spec)
    spec.loader.exec_module(module)
    return module


#: Where rules are marked, the comment that marks them, and the suite that tests them.
MARKED_IN = (
    ("src", "*.py", MARKER, "python"),
    ("firmware/door_logic", "*.h", re.compile(r"^[ \t]*//\s*RULE:\s*(.+?)\s*$"), "firmware"),
)


def marked_suites() -> dict[str, str]:
    """Every rule the source marks, by its words, and the suite whose test must name it."""
    found = {}
    for folder, pattern, marker, suite in MARKED_IN:
        for source in sorted((ROOT / folder).rglob(pattern)):
            for line in source.read_text().splitlines():
                match = marker.search(line)
                if match:
                    found[match.group(1)] = suite
    return found


def marked_rules() -> set[str]:
    """Every rule the source marks, by the words the marker gives it."""
    return set(marked_suites())


def rowed_rules() -> set[str]:
    """Every rule the mutation table claims to switch off."""
    table = tomllib.loads((ROOT / "scripts/mutations.toml").read_text())
    return {str(rule["name"]) for rule in table.get("rule", [])}


def defined_test_names() -> set[str]:
    """Every test function this suite defines.

    Not called ``test_names``: pytest collects anything starting with ``test_``,
    and a helper that returns a set would be reported as a test that forgot to
    assert.
    """
    found = set()
    for module in sorted((ROOT / "tests").rglob("test_*.py")):
        found.update(re.findall(r"^(?:async )?def (test_\w+)", module.read_text(), re.MULTILINE))
    for module in sorted((ROOT / "firmware/tests").glob("*.cpp")):
        found.update(a + b for a, b in re.findall(r"^TEST\((\w+), (\w+)\)", module.read_text(), re.MULTILINE))
    return found


def test_every_rule_in_the_source_has_a_row_in_the_mutation_table():
    """Without this the evidence falls behind the code and nobody sees it happen."""
    marked, rowed = marked_rules(), rowed_rules()
    assert marked - rowed == set(), f"marked in the source and never switched off: {marked - rowed}"
    assert rowed - marked == set(), f"a row for a rule no longer in the source: {rowed - marked}"


def test_every_rule_has_a_test_named_after_it():
    """A kill is only evidence about a rule when the test that went red names it."""
    name_for = _mutate().test_name_for
    named = defined_test_names()
    suites = marked_suites()
    missing = sorted(rule for rule, suite in suites.items() if name_for(rule, suite) not in named)
    wanted = ", ".join(f"{name_for(rule, suites[rule])}()" for rule in missing)
    assert not missing, f"rules with no test named after them — write {wanted}"
