roykollensvendsen/garage-door/(commit log)

2026-11-04 docs: Plan voice control of the garage door before any hardware
    Start the project with a written plan rather than wiring. The plan says
    which of the opener's terminals a small controller should press, traced to
    the manufacturer's own manual rather than guessed; how the controller stays
    electrically separate from the opener; how two magnetic sensors tell whether
    the door is open, closed or in between; and the rules that keep a voice
    command from moving the door without a spoken yes, a known door state and a
    log entry. Nothing has been bought, wired or flashed.
    The repository scaffolding (checks, commit rules, licence, contributing
    guide) comes from the start-repo skill. The repository is pri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
2026-11-04 docs: Check the plan against photos of the opener and board
    Roy photographed the opener's type plate, its terminal block and both sides
    of the controller board. The terminal labels, their colours, the wire bridge
    on 4 and 5 and the 30 V output all match the manufacturer's figure, so the
    push-button input stays on 1 and 2.
    Two things change. No photocells are fitted, so the plan now proposes that
    voice control only opens the door until they are. And the board has a small
    clock crystal beside pins 32 and 33, so the door sensors move to pins 34 and
    35, which can only be inputs and so cannot be driven by mistake.
    The photos stay out of git, since they show a serial number.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
2026-11-04 chore: License the project under the GNU GPL version 3 or later
    Roy chose the same licence as his other projects. Anyone may use, change
    and share the code, and anyone who distributes a changed version has to
    share their changes under the same terms.
    Every source file now says so in a standard one-line licence marker near
    its top, and a new test fails on any file without one, so a file added
    later cannot quietly leave it out.
    Details:
    - LICENSE: the FSF's GPLv3 text, replacing the scaffold's Apache-2.0.
    - pyproject.toml: license = "GPL-3.0-or-later".
    - SPDX-License-Identifier line added to every file in src/, tests/ and
    scripts/; tests/test_licence_headers.py walks src, tests, scripts an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
    [imperative.py, mutate.py, readable.py, test_documentation.py, test_documented_commands.py, test_imperative.py, test_licence_headers.py]
2026-11-04 feat(firmware): Decide door state and when a press may start
    The controller now has its safety logic, written so it runs both on the
    controller and on a laptop with no hardware attached. It reads the two
    magnetic sensors as closed, open, moving, unknown or a fault, and it only
    presses the opener's button input when the door is known to be fully open
    or fully closed. A press lasts half a second, cannot be repeated within two
    seconds, and closing stays switched off until photocells are fitted.
    Writing the tests found one real defect before it shipped: a press was
    never forgotten, so when the controller's millisecond clock wrapped round
    after about 49.7 days the same half-second window would h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
2026-11-04 feat(firmware): Connect the door logic to the board's pins and network
    The controller now has a full ESPHome configuration. It reads the two door
    sensors on pins 34 and 35, drives the opener's button input from pin 25,
    and lets the laptop ask for a press over ESPHome's encrypted connection.
    Every decision stays in the tested logic; this file only carries its
    answers to the pins and the network, every 20 ms.
    Nothing is left open to reach from outside: no web page, no fallback
    Wi-Fi access point, no broker. Updates over the air need a password.
    ESPHome 2026.10.2 checks the configuration as valid; it has not yet been
    compiled for the board or flashed.
    - firmware/garage-door.yaml: api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
    [door_logic_test.cpp]
2026-11-04 feat: Ask before every press and refuse when it is not safe
    The laptop side now holds the rules between a voice request and the
    garage door. Asking to open or close reads the door and returns a
    question to read aloud, such as "The garage door is closed. Open it?",
    with a one-time token. Only a second call with that token presses, so
    nothing can move the door in a single step.
    It refuses, with a sentence that can be read aloud, when the door is not
    known to be fully open or closed, when the controller does not answer,
    when the door is already where it was asked to go (one press would do
    the opposite), when closing is switched off, when the token is spent,
    wrong or older than thirty seconds,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
    [test_service.py]
2026-11-04 feat: Reach the controller over ESPHome's encrypted connection
    The laptop can now talk to the real controller. It connects with
    ESPHome's own client library, reads the door from the controller's "Door
    state" sensor and follows its updates, and asks for a press through the
    controller's "press" action. Anything it does not recognise reads as
    unknown, which the safety rules refuse. A dropped connection is reported
    as "not reachable" and retried on the next call.
    The tests fake the network but hand back the library's own data types,
    so a change in what the library sends fails here rather than at the
    garage. It has not yet been run against the board.
    - src/garage_door/esphome_device.py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
    [test_esphome_device.py]
2026-11-04 feat(firmware): Update over Wi-Fi with fallback, after one USB flash
    Once the first build has gone in over USB, every later update goes over
    the home network, behind a password. The board keeps two copies of its
    program. An update goes into the spare one, and if that one fails to
    start properly the board falls back to the copy that worked, so a bad
    update cannot leave the garage door controller dead. The controller's
    log streams over the same encrypted connection the laptop uses. USB
    remains the way back in, which the plan and README now say.
    Plugging the board in showed that its main crystal runs at 26 MHz rather
    than the 40 MHz the toolchain assumes. A build for the wrong speed would
    garb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
2026-11-04 ci: Run the controller's tests and the safety-rule check on every change
    Continuous integration now checks the whole project on every pull
    request and every push to main, not only the laptop side. The
    controller's logic is compiled and tested on the build machine, which
    needs no board. ESPHome checks the controller's configuration against
    the example secrets. And every safety rule is switched off in turn to
    prove that the test named after it goes red.
    Each of these is a short script, so the contributing guide and the
    workflow run exactly the same line, and the existing documentation test
    keeps the two from drifting apart.
    - .github/workflows/checks.yml: new jobs firmware (apt cmak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
    [test_licence_headers.py]
2026-11-04 ci: Refuse commit messages that link to a Claude session
    A link to a Claude session points into one person's account, so to
    anyone else reading the history it is a dead link. Roy's other projects
    refuse them, and this one now does too: the commit hook refuses such a
    message as it is written, and continuous integration refuses it in the
    commits a pull request or push adds. Credit to Claude as a co-author
    stays.
    The check is the one from claude-voice, adjusted to this repository's
    lint rules. The commits already here were written without such links.
    - scripts/no_session_links.py, tests/test_no_session_links.py: ported
    from claude-voice; print() replaced by sys.stdout/stderr.write.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
2026-11-04 feat: Allow closing by voice, and warn when the door does not close
    Roy decided that closing by voice is allowed even without photocells.
    The controller presses the same button input as the wall button and the
    remote, so the opener reverses on its own if the door meets something,
    exactly as it does with them.
    Closing is still offered only from fully open and only after a spoken
    yes. What is new is the answer when it goes wrong: if the door is not
    fully closed once the travel time has passed, the voice session hears
    "The garage door did NOT close, possibly reversed", and nothing is
    pressed again until someone has looked. Every press is still logged
    with the state before and after.
    Photocell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
    [test_server.py, test_service.py]
2026-11-04 feat: Draw the schematic and cable diagram from the pin plan
    The controller's wiring is now decided in one file, hardware/pins.toml.
    The KiCad schematic is generated from it, so the drawing cannot show a
    different pin from the plan. The cable diagram is a WireViz file.
    Tests check that the firmware, the schematic and the cable diagram all
    use the planned pins. They also fail when a source changes but the
    pictures in docs/wiring/ were not rendered again.
    CI also opens the schematic in KiCad itself. There it must pass the
    electrical rule check with no warnings. KiCad's own netlist must also
    join exactly the pins the plan intends. A drawing that looks right but
    connects the wrong pins fails th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
    [garage-door.kicad_sch]
2026-11-04 docs: Add a step-by-step build guide
    Someone who wants to build the controller now has one page to follow.
    It covers the safety steps first, then the parts by part number, the
    schematic and the cable diagram with the same circuit in words, and
    nine steps from measuring the opener's input to the first voice command.
    Each safety step cites the opener manual's page: unplug before opening
    it, leave the 4-5 bridge, use only terminals 1 and 2, test force
    reversal. The README links to the guide.
2026-11-04 feat: Simulate the door, so everything runs without the garage
    Contributors, and CI, can now run the whole chain with no door. A
    simulated door models the opener: one press opens, closes or stops it,
    and a closing door that meets an obstacle reverses. It reports through
    two simulated reed contacts.
    The firmware's own logic drives it in the C++ tests, millisecond by
    millisecond. The laptop's service drives it in the Python tests. Both
    check the cases that matter: an obstacle gives "did NOT close" with
    one press only, and a door stopped part-way is never pressed.
    `garage-door-mcp --simulate` serves the same tools against the
    simulated door, so anyone can try the voice flow with Claude. It sa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
    [door_sim_test.cpp, test_server.py, test_simulator.py]
2026-11-04 feat: Keep the opener compatibility list as one file per model
    Which openers the controller works with is now data: one YAML file per
    model in hardware/openers/, each citing the manual page for its
    push-button terminals. The compatibility pages are generated from it.
    Adding an opener is then one file, with no page to edit.
    The four models in the LM80EVF's manual are listed. All are "untested"
    until a controller has opened and closed a real door, the LM80EVF
    included. A template and the generator's check say what is missing.
    - scripts/openers.py writes docs/compatibility.md and
    docs/openers/<model>.md; --check fails if a page is stale or a file
    lacks a terminal source.
    Co-Auth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
    [openers.py]
2026-11-04 docs: Build a project site, ready to publish when the repo is public
    People who find the project now get a site that explains it: what it
    does and why, a demo placeholder, "build it in an evening" with cost
    and time, the build guide, an honest safety page, voice and MCP use,
    questions, builds and how to contribute. The README opens with the
    same pitch, a few badges and links to each page.
    Agents get the same content as text. Each page is also published as
    Markdown, with llms.txt as an index and llms-full.txt with everything.
    CI builds the site in strict mode, so a broken link fails. Publishing
    to GitHub Pages is skipped while the repo is private, and starts by
    itself once it is public.
    De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
    [test_documented_commands.py, test_site.py]
2026-11-04 feat: Check that project skills stay small, findable and unduplicated
    Project skills are where this repo keeps what it has learnt, so they
    now get the same care as code. A linter fails a skill whose SKILL.md
    passes 500 lines or has no name or description. It also fails one whose
    description is vague or never says when to use it, has a broken link,
    or copies a long sentence from another skill. A ratchet against
    .claude/skills/baseline.json stops a skill growing, or gaining warnings,
    without the baseline being changed in review.
    Around it: a pre-commit hook and a CI gate, a PR checkbox, a soft PR
    comment when code changes without a skill, a Stop hook that asks once
    per session whether a lesso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
    [skill_lint.py, test_skill_lint.py]
2026-11-04 fix: Read folded skill descriptions and skip example links
    Run over Roy's 38 global skills, the skill linter raised false alarms.
    It read a description written as a YAML block (`description: >`) as one
    or two characters. It also reported links inside code examples and in
    assets/ templates as broken, but those are meant for another repo.
    Now it reads the whole block, ignores links in code, and skips assets/.
    It also accepts a Norwegian "bruk når" as saying when to use a skill.
    [skill_lint.py, test_skill_lint.py]
2026-11-04 docs: Weigh reading the door state without extra sensors
    Roy asked whether the door's state can be known from the opener alone,
    before anything is bought. The plan now answers with sources. The 0+2
    bus is read on related EU EV openers ratgdo-style, but is unproven on
    this one, with an unknown voltage. 6+7 with timing cannot tell the
    direction or survive a power cut. A time-of-flight sensor at the
    opener is the short-wire fallback, if sunlight is managed.
2026-11-04 docs: Record Roy's measurements on his opener
    Roy measured his LM80EVF on 2026-11-04. Terminals 1+2 carry about 10 V
    DC when idle, well inside the relay's 60 V. Joining them by hand for
    half a second opened the door, then stopped it, then closed it: the
    manual's one-input cycle. That cycle is why a press is refused unless
    the door is known to be fully open or closed. The 30 V output reads
    about 1.1 V idle, so standby switches it off. 0+2 and 6+7 are still to
    be measured.
    - docs/plan.md: "Measured on Roy's opener"; build guide step 1-2.
    - hardware/openers/lm80evf.yaml: 10 V, and a new `checks` list
    ("Roy, 2026-11-04"), shown on the opener's page. Still "untested"
    until the contr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
2026-11-04 docs: Record that terminals 0+2 look like a data bus
    Roy measured 0+2 on his LM80EVF. It reads about 10 V idle, and 11.17 V
    once the door has run. While the door moved, the DC reading dipped and
    frequency mode briefly showed about 285 Hz. That points to bursts of
    serial data, as a Security+ 2.0 bus would carry, but a multimeter
    cannot prove it.
    The plan's next step is a listen-only capture of 0+2, through a
    high-impedance divider or an optocoupler, decoded with secplus or
    ratgdo. If door-state messages decode reliably, no extra sensors are
    needed.
2026-11-04 docs: Add the 0+2 reading right after a stop
    Roy's meter showed about 27.27 Hz on 0+2 right after the door was
    stopped, against about 285 Hz while it moved. The reading changes with
    what the door is doing, which is more evidence that the opener sends
    status on this line. It is still not decoded.
2026-11-04 docs: Add the 0+2 reading with the door closed
    With the door stopped fully closed, Roy's meter showed about 17.51 Hz
    on 0+2. Moving gave about 285 Hz, and stopped part-way about 27.27 Hz.
    A different reading for each state is what status packets would cause.
    It is still not decoded.
2026-11-04 docs: Correct the 0+2 frequency notes: quiet while moving
    Roy corrected his readings. Frequency mode on 0+2 shows 0 Hz while the
    door moves. A value appears only briefly around each change of state:
    about 285 Hz around the start, 27.27 Hz at a stop part-way, 17.51 Hz
    when stopped closed. The notes said the 285 Hz came while moving.
    So the line has bursts at state changes and is quiet in between. A bus
    that sends status on change would look like that, but it is still not
    proven until the line is captured.
2026-11-04 test: Cover the command line and the last untested paths
    The laptop code was at 94 %. The command line was never run. Three paths
    had no test: the controller stopping between the question and the press,
    a wrong token through the MCP tools, and the simulator's own refusals.
    Each now has one, and coverage is 100 % of statements and branches.
    [test_cli.py, test_server.py, test_service.py, test_simulator.py]
2026-11-04 build: Fail the tests when coverage drops below 95 %
    Coverage was printed but nothing failed on it. The floor sits below
    today's 100 % on purpose. The quality ratchet will hold the level
    reached; this catches a drop even when the ratchet was told to allow
    one. just test-python now measures coverage too, as CI does.
2026-11-04 test: Name an out-of-range state or result as the safe one
    A corrupted value passed to to_string fell through to the fail-closed
    names, but no test ran those two lines. Now one does, so a change that
    named such a value "closed" or "accepted" would fail.
    [door_logic_test.cpp]
2026-11-04 ci: Measure firmware coverage, with a floor
    Only the laptop code's coverage was measured. The firmware tests now
    build a second time with gcov, and gcovr reports the lines and branches
    of firmware/door_logic/ they run: 100 % of lines and 98 % of branches.
    CI fails below 95 % of lines or 90 % of branches. The quality ratchet
    will hold the level reached.
    [test_licence_headers.py]
2026-11-04 test: Switch off each firmware safety rule and see its test fail
    Mutation testing covered only the laptop's rules. The controller's eight
    rules in door_logic.h are now marked // RULE: and have rows in
    scripts/mutations.toml with suite = "firmware". mutate.py builds and
    runs the GoogleTest suite for those rows. A mutation that does not
    build stops the run instead of counting as a kill.
    Each rule must turn red the GoogleTest whose suite and name are its
    words in CamelCase, and test_rules_have_evidence checks that test
    exists. All 8 do, so 15 of 15 rules are guarded. CI runs each suite's
    rules in its own job, with --suite.
    [mutate.py, test_rules_have_evidence.py]
2026-11-04 ci: Add the quality ratchet
    The floors catch a large drop; nothing stopped a small one. quality.json
    now records every measured level, on the model of claude-voice: both
    coverages, mutation of all 15 rules, both test counts, lint and type
    errors. Also import cycles, layer breaches, oversized modules, copied
    code and the most complex function per module.
    The ratchet CI job measures the change and fails if any level got
    worse than the base's. A line "Ratchet-Exception: <measure> - why" in
    the pull request or a commit message allows one measure to drop. A
    level that got better must be recorded in the same change. The Python
    suite also has a time budget, set by hand: 30 s, plus 50 %.
    Co-Author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
    [ratchet.py, test_ratchet.py]
2026-11-04 docs: Record the 0+2 oscilloscope capture and how to measure the bit rate
    Roy put a scope on terminals 0+2 and pressed the remote. The line idles
    at about 10-12 V, drops to 0 V for 2-3 ms, then carries a burst of short
    pulses. So 0+2 is a serial data line, as a Security+ 2.0-style bus
    would be, though not yet proven.
    The plan now says how to get the bit rate: the scope settings, the
    cursor measurement, and the scope's UART decode. It also proposes an
    isolated, receive-only ESP32 input for the line. The opener profile
    and the skill's notes record the capture.
2026-11-04 docs: Record the 0+2 bit time and how to decode it
    Roy measured the pulse widths on 0+2 with the scope's cursors. After a
    break of 2.5-3 ms they are 1, 2, 2 and 4 bits long, about 126.6 us per
    bit. That is about 7900 baud, probably 7812.5 or 8000 nominal, not the
    9600 that ratgdo uses for Security+ 2.0.
    The plan now says what ratgdo and secplus do say about the rate, and
    that nothing found documents this rate for the EU EV series. It also
    says how to decode the line: on the scope's UART decoder, or on the
    ESP32, raw timings first, then bytes.
2026-11-04 docs: Add the 0+2 break length and a six-bit pulse
    Roy measured two more widths on 0+2. A high of 754.4 us is six bits,
    which puts the bit time at about 126 us, about 7900 baud. The break
    before each message is 2.624 ms, about 21 bit times, so it is a UART
    break that marks where a message starts.
    The decoding plan now says to treat that break, which a UART reads as a
    0x00 byte with a framing error, as the start of a message, not as data.
2026-11-04 feat: Decode a scope capture of the opener's serial line
    The scope saves a waveform as CSV, but reading bits off a screen by hand
    had given the wrong bit time. scripts/decode_capture.py reads the CSV,
    splits it into high and low runs with hysteresis, and fits the bit
    time. It starts from the shortest run, because any whole fraction of
    the bit fits equally well. It then decodes UART 8N1 and marks the
    Security+ 2.0 sync 55 01 00.
    Captures are several MB, so docs/captures/ is git-ignored and kept off
    the site. quality.json records the two new tests.
    [decode_capture.py, test_decode_capture.py]
2026-11-04 docs: Propose a resistor divider for the first 0+2 bench test
    Roy wants the first listen-only test of 0+2 to load the line as little as
    possible, with parts he has. The plan now gives a 39k/12k divider into
    GPIO36, through 1k with a Schottky clamp to 3V3. It works out the levels
    from 11.2 V to 15 V, the load and the timing. It says plainly that the
    divider is not isolated, so the laptop runs on battery and the build
    keeps the optocoupler.
2026-11-04 docs: Record the decoded 0+2 status packets for open, close and stop
    Four whole packets from the opener's 0+2 line were captured on the scope
    and unscrambled with argilo's secplus. All four are status messages from
    the opener itself. Only the door state changes between them: opening,
    closing or stopped. The rolling code counts up.
    So the controller could read the door state by listening on 0+2, without
    magnet sensors. The event order for three of the captures is Roy's
    recollection, and the decode agrees with it.
2026-11-04 docs: Propose reading and pressing over the opener's data wire
    Roy's scope captures show the opener reports its door state on terminals
    0+2. Roy asked to use that wire both to read the state and to press.
    The decision record proposes how, and the plan and safety table follow it.
    Reed contacts and the relay stay as choices. A status older than two seconds
    counts as unknown. On the wire, only open, close and status requests are ever
    sent. Nothing is wired or sent until Roy approves.
2026-11-04 build: Take in argilo's secplus coder for the opener's data wire
    The opener's data wire speaks Security+ 2.0, and argilo's secplus is the
    coder ratgdo uses for it. Copying it in unchanged at a fixed commit is
    safer than rewriting its bit shuffling.
    A test checks the copied files against their recorded hashes, so nobody
    edits them by accident. The README says the PyPI package with the same name
    is unrelated.
    [test_licence_headers.py, test_third_party.py]
2026-11-04 feat: Read the door state from the opener's data wire, and build door commands
    The controller can now take the door's state from the opener's own status
    messages instead of the reed contacts. Open and closed mean what they say,
    opening and closing count as moving, and anything else is unknown. A status
    older than two seconds is unknown too, so a press needs a fresh one.
    It can also build the two packets it may send on the wire: a status request,
    and open or close. The direction follows the state the press was accepted
    in, so a press never toggles. The rolling code only moves forward, also
    across a restart.
    The tests use Roy's four captured packets. The four new rules each fail
    their named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
    [opener_wire_test.cpp]
2026-11-04 docs: Keep the relay as the way to press until the wire is proven
    Roy wants the relay to press the door until pressing over the opener's data
    wire has been tested on the bench. The decision record now says so, and
    that the wire is only read, or asked for its state, until then.
2026-11-04 feat: Add a test mode in which a press never switches the relay
    Roy will update and test the controller over Wi-Fi while it sits in the
    garage. In test mode every press is judged and reported as usual, but the
    relay stays open. The controller starts in test mode after every boot and
    update, so a new build never moves the door until Roy arms it.
    Switching test mode on cuts a press that is already running. The rule fails
    its named test when switched off.
    [door_logic_test.cpp]
2026-11-04 feat: Find and decode packets on the opener's data wire as bytes arrive
    The controller needs to pick the opener's packets out of what its serial
    input receives. The framer skips the break and noise, starts at the sync
    bytes, and drops a packet cut short by a pause. The listener remembers the
    opener's last status and when it came, and tells other or broken packets
    apart, so all of them can be logged.
    Tested with Roy's captured packets, fed at the line's own pace.
    [opener_wire_test.cpp]
2026-11-04 feat: Log the opener's wire, and add test mode and diagnostics
    The controller now listens on the opener's data wire (terminal 0, through
    the divider, on GPIO36). It logs every packet over Wi-Fi as hex and decoded,
    and shows the opener's last status. It never sends: there is no transmit
    pin, and a test keeps it that way. The door state can come from the wire or
    from the reed contacts.
    An "Armed" switch turns test mode off. The controller starts unarmed after
    every boot and update. It also reports its Wi-Fi signal, uptime, version and
    the reason for its last restart. A restart button leaves the door alone.
    Updates over Wi-Fi are now encrypted with their own key, as ESPHome
    recommends, instea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
2026-11-04 feat: Check the controller and switch test mode from the laptop
    `garage-door check` prints what the controller reports: door state, test
    mode, the opener's status on the wire, Wi-Fi signal and version. `arm` and
    `disarm` switch test mode. None of them presses the door. Each refuses
    before connecting when the address or key is missing.
    There is no web server and no Home Assistant, so without these commands
    the controller could not be armed at all.
    [test_cli.py, test_esphome_device.py]
2026-11-04 docs: Note a 3D-printed enclosure as deferred
    Roy wants a parametric OpenSCAD enclosure, with STL files built by CI and
    attached to releases, but not yet. The parts and their layout are not
    settled, so a box drawn now would be drawn twice.
2026-11-04 feat: Use the bench divider values from Roy's kit, and draw it
    Roy's resistor kit has no 39k or 12k, so the divider is now 22k plus 10k
    over 10k. Node A reads 2.67 V at 11.2 V and 3.57 V at 15 V. The load is
    42 kOhm. The original pair still works and is named as an alternative.
    The values live in the pin plan. A script draws a schematic and a
    breadboard view from them, with each resistor's colour bands and where to
    put the meter. Tests check the levels against the ESP32's limits and that
    the pictures are current. The build guide and the parts list have the bench
    test.
2026-11-04 docs: Use a 1N4148 clamp for the first test, and list add-on sensors
    Roy has a 1N4148 but no Schottky yet. It clamps only at about 3.9 V, but
    the divider alone stays at 3.57 V even at 15 V, so it is acceptable for the
    first test. A permanent build uses a Schottky. The pictures are redrawn.
    The sensors Roy already has are listed as possible add-ons for later.
2026-11-04 docs: Propose an isolated 6N136 input for the opener's data wire
    The divider stays the circuit for the first test, but it ties the ESP32's
    ground to the opener's. For the permanent build, Roy's 6N136 optocouplers
    keep the two apart, like the relay does for the press.
    A 10k resistor draws about 1 mA from the line. A 22k pull-up on the output
    gives enough margin at the opto's minimum gain, with a second 10k as the
    fallback. The output inverts, and the edges are fast enough for 4000 baud.
    The values live in the pin plan, and a script draws the schematic from them.
    [opto_input.py, test_bench_divider.py]
2026-11-04 docs: Draw the bench divider in Roy's breadboard layout
    Roy is building the divider now and wants the picture to match his board.
    Each part is now drawn between his column numbers, with node A in column 9.
    The wires use his colours: red to terminal 0, black to ground, yellow to
    GPIO36, blue to 3V3. The meter goes on columns 9 and 13. The ESP32 runs
    from a USB power bank, not the laptop, and the build guide says the same.
2026-11-04 fix: Divide the opener's line by 22k over 10k, as Roy measured
    With 22k plus 10k over 10k, node A read only 2.4 V mean on Roy's scope,
    too close to the ESP32's input-high level. With the extra 10k jumpered out
    it read 3.17 V, so the line's high level is about 10.1 V. It carries 50 Hz
    ripple and short spikes from the opener's supply, not data.
    From about 11.5 V up, the 1N4148 now conducts and holds GPIO36 near 3.9 V,
    at most 0.1 mA. That is above the pin's maximum, so a Schottky is needed for
    keeps. The filter is 1 nF, not 10 nF: about 7.9 kOhm feeds it, so 10 nF would
    give 79 us and round off 250 us bits.
    The plan also says what to do if the ripple's troughs stay under the input
    level. Tes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
    [bench_divider.py, test_bench_divider.py]
2026-11-04 docs: Record the opener's own status message while the door is idle
    Roy captured a packet the opener sent by itself, with no remote pressed.
    secplus decodes it as status 0x081 from the same device: door closed (2),
    light off. The rolling code moved 63 in five hours, so the opener repeats
    its status about every five minutes while idle.
    That answers one open question in ADR-GD-003. It does not loosen anything:
    a status every five minutes is far older than the two seconds a press needs.
2026-11-04 docs: Draw Roy's test breadboard exactly as he built it
    Roy built the listen-only divider on a half-size breadboard and gave every
    hole by voice. The pin plan now holds that layout, and a new script draws
    it: each part between its two holes, the green jumper over the unused 10k,
    the 10 nF to ground through a wire to the rail, and every wire named,
    including the three not yet connected to the ESP32.
    His scope readings sit beside the drawing. The build guide lists the same
    holes as a table. The breadboard drawing moved out of bench_divider.py,
    which had reached its size limit. Tests check that every hole exists on a
    half-size board and that the picture is current.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
2026-11-04 feat: Let the relay's trigger level be set in one place
    Roy's relay module for the first door test may switch on a low input, and
    nothing on it says which. A relay_active_low substitution now sets the press
    output's level, so "off" means relay open whichever module is fitted. It
    stays "false" for the AQY212EH until a bench check shows otherwise.
    ESPHome drives the output off during setup, and GPIO25 is not a strapping
    pin. Tests check that the level is set only by the substitution and that
    nothing restores the output on after a restart.
2026-11-04 docs: Use Roy's relay module for the first door test
    Roy has a Songle SRD-03VDC-SL-C relay board. It is used for the first door
    test, and the AQY212EH stays the part for the permanent build. The pin plan
    records its terminals, and a script draws the wiring: CTL on GPIO25, COM and
    NO across terminals 1 and 2, NC empty so a dead module never presses.
    Its trigger level is unknown. The build guide adds a bench check with the
    opener disconnected: no click on power-up, which input level clicks it,
    setting relay_active_low to match, and one press on the meter before the
    opener is wired. It also notes the coil's 120 mA on the Thing's regulator,
    and power banks that switch off at low draw.
    Co-Autho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
2026-11-04 docs: Wire Roy's relay module through its active-high input
    Roy read the module's input terminal again: VCC, GND, CTH, CTL, with no
    COM. CTH triggers on a high input and CTL on a low one. CTH is used, so a
    low or floating GPIO25 at boot, after a crash or during a reset leaves the
    relay open. The firmware already drives it that way (relay_active_low
    "false"), and the controller starts unarmed after every boot.
    The pin plan, relay drawing, as-built breadboard and build guide now show
    the planned wires: relay VCC to row 17 (3V3), relay GND to the rail, CTH
    straight to GPIO25. The bench check tests CTH directly instead of guessing
    the trigger level.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
    [bench_breadboard.py, bench_relay.py]
2026-11-04 feat: Refuse commits that would carry the controller's secrets
    firmware/secrets.yaml and ESPHome's build output were already ignored, but
    nothing checked what the files themselves contain. A scan now refuses any
    staged file that holds a value from the local secrets.yaml, or any 32-byte
    key other than the example. The pre-commit hook runs it on each commit, and
    the tests run it on every tracked file, as does CI.
    Tests also check that git ignores the secrets file and ESPHome's generated
    sources, which carry the Wi-Fi password once built.
2026-11-04 fix: Encrypt updates over Wi-Fi with the API key
    ESPHome 2026.10 refuses an OTA key that differs from the API key, and Roy's
    first flash stopped there. CI never saw it, because the example secrets used
    the same key for both. OTA now uses the API key, the separate key is gone
    from the example, and a test keeps it out.
    [test_hardware.py]
2026-11-04 docs: Record Roy's first flash and relay bench results
    The relay module triggers on CTH as labelled. The firmware flashed over USB
    and joined Wi-Fi, and the relay stayed open through power-up, flashing and
    reset. The check over Wi-Fi read it unarmed, with the door state "fault":
    the reed inputs float with nothing fitted, and the controller refuses
    every press.
    The "other watchdogs" restart reason follows the USB adapter's reset at
    power-up, and the log shows nothing wrong after it. The guide says when
    that reason would mean a real problem.
2026-11-04 test: Check licence headers only on files git would see
    After Roy's first flash, ESPHome's toolchain under firmware/.esphome/ and
    the local secrets.yaml sat in the tree. The test walked into them and failed
    on code that is never committed. It now leaves out what git ignores.
    [test_licence_headers.py]
2026-11-04 fix: Wait for the controller's first report before reading the door
    The controller sends its states a moment after the laptop connects. The
    first state() call read before they arrived, so the first request after a
    start always saw "unknown" and was refused. Roy hit this on the bench: the
    check showed "closed", but an open request was refused.
    state() now waits up to 3 s for the first door report after connecting. If
    none comes, it still reads UNKNOWN and the service still refuses. Nothing
    else about when a press is allowed changes.
    [test_esphome_device.py]
2026-11-04 docs: Record the first press on the bench: the relay clicks
    With "closed" faked by wires and the controller armed, Roy asked by voice
    to open, twice, and said yes each time. The controller accepted both, and
    the relay clicked. The service reported that the door did not reach open,
    which is right with nothing on the relay's output. The guide also notes the
    first-read bug found and fixed along the way.
2026-11-04 feat: Say when the controller is in test mode
    After every restart the controller is not armed: it judges and logs a
    press, but the relay stays open. The voice tools never said so. Tonight
    two presses came back "Pressed, but the garage door did not reach open",
    the same words a wiring fault would give.
    Asking for the door's state now also says whether the controller is
    armed. A press in test mode says the relay did not switch, and answers
    at once instead of waiting 30 s for a door that cannot move. When the
    controller has not said, a press that does not arrive says that too.
    The press itself is unchanged: it is still sent, and the controller
    still decides.
    The details, for whoever maintains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
2026-11-04 docs: Allow a manual press while Roy watches the door
    The first tests on the real door come before the controller can tell where
    the door is, so every press meets the fail-closed rule. Roy's point: when he
    stands at the door and says yes to each press, he is the safety check, as he
    is at the wall button.
    ADR-GD-004 records the one exception, which Roy approved: a manual press
    with no direction. It needs the controller armed and manual mode on, which
    is off at boot and switches itself off after 10 minutes. It skips only the
    known-state rule; the spoken yes, the rate limit, the half-second press and
    the log stay. Hard rule 3 in AGENTS.md names the exception in the text Roy
    approved. Nothing i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
2026-11-04 feat: Let the controller accept a manual press while Roy watches
    ADR-GD-004 allows one exception to fail-closed: a press with no direction,
    which Roy approves while he watches the door. The controller now has a
    "Manual mode" switch, off at every boot and update, that turns itself off
    after 10 minutes. It also has a manual_press action, which skips only the
    rule that the door's state must be known.
    A manual press is still refused when the controller is not armed, while the
    door is known to be moving, and inside the half-second press or the
    two-second gap. Both kinds of press now share those two timing rules. An
    ordinary press still needs a known state, even with manual mode on.
    Each new rul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
    [door_logic_test.cpp, test_hardware.py]
2026-11-05 feat: Log every byte on the opener's wire that is not a packet
    In the garage test, the opener's rolling counter skipped 8 of 22 values
    and the log showed nothing for them. The framer dropped bytes silently
    while it looked for the 55 01 00 sync, and when a pause cut a packet
    short. Now it counts every byte it skips and keeps the first 32. The
    controller logs them as "skipped N bytes outside any packet", so a
    counter gap can be told apart: a packet that arrived damaged, or nothing
    on the wire at all. Nothing changes in which packets are read.
    [opener_wire_test.cpp]
2026-11-05 docs: Record the relay output check in the garage
    Continuity puts COM on the middle screw and NO on the right, open at
    rest. Bridging CTH to VCC clicks the relay and closes COM-NO. The output
    is still not connected to the opener.
2026-11-05 docs: Record that the relay stays off at boot on the real opener
    With COM and NO wired to opener terminals 1 and 2, a power cycle of the
    ESP32 moved nothing and clicked nothing. The controller came back
    unarmed, with manual mode off.
2026-11-05 feat: Count how well the opener's wire is heard, as sensors
    Only about 8 of the 19 bytes of the opener's 5-minute status reach the
    parser. Nine counters since boot now show where the rest go: bytes
    received and skipped, packets decoded and failed, rolling codes that
    never came, and the UART driver's framing and parity errors, overflows
    and breaks.
    ESPHome's uart component hides the driver's errors, so the wire's UART
    is now set up with ESP-IDF itself (wire_uart.h), on the same pin at the
    same speed. It still never assigns a TX pin; a test checks that.
    [opener_wire_test.cpp, test_hardware.py]
2026-11-05 docs: Record the bad jumper wires and the removed 10 kΩ
    Three manual presses were accepted but the door did not move. Several
    blue jumper wires had no continuity (bad crimps). Roy replaced the
    relay's output wires and checked every wire on the bus side. He also
    took out the shorted 10 kΩ at c5-c9, so it leaves the as-built
    breadboard drawing.
2026-11-05 fix: Listen on the opener's wire at 9600 baud
    Since the opener was power cycled, every packet arrived as 8 bytes
    starting 18/38/88/98 00, with no framing errors. A 4000-baud UART reads
    a 19-byte packet sent at 9600 exactly like that; a model of the UART
    gives 8 bytes starting 18 00. 9600 is the speed ratgdo uses for
    Security+ 2.0. Swapping the 10 nF filter for 1 nF changed nothing. The
    speed is now one substitution, wire_baud.
    [test_hardware.py]
2026-11-05 docs: Record the first press through the relay that moved the door
    Manual mode, armed, after a spoken yes: the door went from fully open to
    closed. The opener answered on its wire a second later and again at the
    end of travel, about 20 s on.
2026-11-05 docs: Record that the opener now talks at 9600 baud
    After a power cycle, every packet reached the 4000-baud UART as 8
    garbled bytes. At 9600 whole packets decode again: closed, opening and
    open, with no rolling-code gap. Why it ran at 4000 before is not known.
2026-11-05 feat: Take the door's state from the opener, trusting its last status
    Roy chose this on 2026-11-05 (ADR-GD-005). The controller now reads the
    door's state from the opener's wire, not from the unfitted reed contacts.
    How long a status counts is a choice. "last_status", the default, trusts
    it for 6 minutes, past the opener's 5-minute repeat. "ask_first" keeps
    the 2 s limit of ADR-GD-003, which refuses every press until a sender
    can ask.
    Trusting the last status, the door is unknown and every press refused
    when the status is too old, when a moving door was last heard longer
    ago than its travel time, or when stray bytes or a broken packet came
    after the last status. Tests were written first; 33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
    [door_logic_test.cpp, opener_wire_test.cpp, test_hardware.py]
2026-11-05 docs: Record the first open by name, with the state from the wire
    The controller read "closed" from the opener's status, asked, and after
    Roy's yes the opener reported opening at once and open 18 s later.
2026-11-05 feat: Arm and switch manual mode by voice, each after a spoken yes
    Roy asked for it on 2026-11-05 (ADR-GD-006). The MCP server gets a new
    tool, garage_switch. Arming or turning manual mode on asks a question
    first, and garage_confirm switches only after Roy says yes, once and
    within 30 s, as for a press. Disarming and turning manual mode off
    happen at once. Every switch is logged with the presses.
    The controller's own rules stay as they are. It is unarmed at boot, and
    manual mode turns itself off after 10 minutes. The firmware does not
    change. 35 of 35 rules fail their test when turned off.
    [test_server.py, test_switches.py]
2026-11-05 feat: Let the MCP server read its key from the firmware's secrets file
    garage-door-mcp --secrets-file firmware/secrets.yaml --host <address>
    reads api_encryption_key itself. A launcher such as the claude-voice
    bridge then never holds the key. GARAGE_DOOR_HOST and
    GARAGE_DOOR_API_KEY still win when they are set. A missing file or key
    stops the server with a reason, and the key is never printed.
    [test_server.py]
2026-11-05 feat: Report the opener's light in every answer, read only
    The opener's status on the wire says whether its light is on. The
    controller now reports it as "Opener light", along with "Opener status
    age", the seconds since that status. Every answer's controller block
    gains "light" (true, false or null) and "light_age_s". The light is null
    when no status has come in the last 6 minutes, the same limit the door
    state uses (ADR-GD-005). Nothing switches the light.
2026-11-05 fix: Word every confirmation as a plain question when spoken
    Read aloud by the voice, "The garage door is closed. Open it?" sounded
    flat, and Roy did not notice he was being asked. Each question now asks
    "Do you want me to …?" for open and close, the manual press, arming and
    manual mode. Only the wording changes; what is pressed, and when, stays
    the same.
    [test_manual.py, test_server.py, test_service.py, test_switches.py]
2026-11-05 fix: Tell the voice to keep one question open and confirm the newest
    At 14:38 the voice asked twice, 3 s apart, then confirmed with the first
    token. The server refused it, as it should: only one question is open at
    a time, and a wrong token cancels it. The instructions now say not to
    ask again while a question is open, and to confirm only with the newest
    token. The confirm tool says that an old token cancels the question. The
    rule itself is unchanged.
    [test_server.py]
2026-11-05 docs: Propose switching the opener's light by voice over the data wire
    Roy asked for it by voice. ADR-GD-007 is Proposed and covers four parts:
    an isolated sender on 0+2, and the light command only, bench-tested with
    Roy before anything else. A garage_light tool works without a spoken yes
    but only when armed, and is always logged. A status request reads the
    result back. Nothing is built until Roy approves.
    Also recorded: the light goes out about 2 min 50 s after the door stops
    (Roy, by eye).
2026-11-05 docs: Mark the LM80EVF as tested on Roy's opener
    The controller opened and closed Roy's door on 2026-11-05, through the
    relay and by voice, with the door state read from the opener's data
    wire. The opener's file records that day's checks: 9600 baud, every
    status decoded, the voice presses, and the light timing. The
    compatibility pages are regenerated, and the design's feature row now
    says the opener reports its own state.
2026-11-06 feat: Let a magic phrase stand in for the spoken yes
    Roy asked for this on 2026-11-06 (ADR-GD-008), for both open and
    close, with no length limit. garage_request takes an optional phrase.
    When it holds one of the user's own phrases for that action, the server
    presses at once. Otherwise the usual question comes back.
    The phrases live per language in ~/.config/garage-door/phrases.toml,
    outside git. The server refuses to start if others can read that file,
    and with no file the feature is off. Matching ignores case, punctuation,
    spacing and accents. It counts a repeated word once, and forgives one
    letter slip in a word of five letters or more. The whole phrase must be
    there, in order.
    Every ot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
    [test_phrases.py, test_server.py, test_service.py]
2026-11-06 fix: Let one magic phrase both open and close
    Roy wants the same phrases for both directions, and confirmed it in this
    session. The door's state already decides the direction, and a press the
    wrong way is refused as already open or already closed. The docs now
    call the phrases a convenience setting, not a secret, kept outside git
    because they are the user's own.
    [test_phrases.py]
2026-11-06 build: Build the site with Zensical instead of MkDocs Material
    Material for MkDocs gets no updates after 5 May 2027. Zensical is its
    successor from the same team, and it reads the same mkdocs.yml. Zensical
    has no hooks, so the step that publishes each page as Markdown, with
    llms.txt and llms-full.txt, now runs as a script after the build. It
    reads the menu from mkdocs.yml and puts pages outside the menu under
    "More pages". The strict build reports no issues, and it gives the same
    pages as before.
    [site_text.py, test_site.py]
2026-11-06 refactor: Take the door state only from the opener's data wire
    Roy has dropped the reed contacts; they were never fitted. The door's
    state has come from the opener's own status on 0+2 since 2026-11-05, so
    the firmware loses the two reed inputs and the state_from switch, and the
    pin plan, cable plan and schematic lose the pull-ups, filters, terminals
    J3 and J4, and cables W2 and W3. The schematic and cable diagram are
    regenerated. A new test checks that the state comes only from the wire.
    The reed logic in door_logic.h stays with its tests and mutation rules,
    for anyone whose opener has no such wire. GPIO34 and GPIO35 are free for
    them. Nothing is pressed differently: the running build alrea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
    [garage-door.kicad_sch]
2026-11-06 docs: Describe the build without reed contacts
    The home page, build guide, plan, safety page, FAQ and design page now say
    that the door's state comes from the opener's data wire, with no sensors
    on the door. The parts lists drop the reed contacts and the alarm cable,
    the plan's state table follows ADR-GD-005, and the plan notes the 9600 baud
    the opener has used since its power cycle. Bench results from before the
    change are kept as they happened.
2026-11-06 feat: Find the opener's wire speed by itself
    The opener changed its speed on its own at 02:05 on 2026-11-06, as it did
    after a power cycle on 2026-11-05. Every byte still arrived, but nothing
    decoded, so the door state stayed unknown for eight hours. WireSpeed now
    watches the listener's counters. When two bursts in a row end with nothing
    decoded, it moves the UART to the next speed, 9600 or 4000. One decoded
    packet starts the count again, and a silent wire never changes it.
    The door state still comes only from packets that decode, so this changes
    nothing about when the door is pressed. The new tests use the garbled
    bytes from that night's log and a real status at 9600. The speed is
    reported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
2026-11-06 docs: Record that the opener changed its wire speed again by itself
    From 02:05 on 2026-11-06 the opener's packets no longer decoded at 9600
    baud, with the controller still running and nobody at the opener. The
    opener notes, its page and the opener skill now say so, and point to the
    speed finder.
2026-11-06 fix: Reconnect after the controller restarts, and forget old readings
    When the controller restarted after the update at 11:13 on 2026-11-06,
    the MCP server never noticed that the connection had ended. It kept
    answering from what it had heard before: armed from the evening before,
    and the light's age frozen at 33058 s. It now asks aioesphomeapi to report
    when the connection stops. Then it drops every reading, and connects
    again on the next request. Until the controller reports afresh, the
    door reads unknown and armed reads not known, so a request is refused.
    [test_esphome_device.py]
2026-11-06 docs: Show the 1 nF filter on Roy's breadboard
    Roy swapped the 10 nF on d13-d15 for a 1 nF on 2026-11-05, as the opener
    notes say, but the breadboard drawing and its table still showed 10 nF.
    The scope readings taken with the 10 nF are kept and marked as such.
2026-11-10 feat: Open each garage tool with a short sentence of its own
    The Claude app shows the voice one cut line per unloaded tool, so only
    about 26 characters of each description were visible and three of them
    started almost alike. Each tool now opens with a short, whole sentence
    on a line of its own that says what sets it apart, with a different
    first word; the full description, safety rules included, follows
    unchanged. A test keeps the opening short, whole and distinct.
    [test_server.py]
2026-11-10 fix: Fit each garage tool's opening in 26 characters
    The voice sees only about 26 characters after the connector's label,
    so openings of 30 to 33 were still cut. Each is now 26 or fewer, and the
    test's limit is 26. The rest of every description is unchanged.
    [test_server.py]
2026-11-10 ci: Let the site and KiCad jobs run on GitHub
    The first run on GitHub, after the repository went public, failed two jobs
    that had never run before. The site job ran the opener script without
    pyyaml, which only the dev extra installs, so it now syncs every extra
    first. The KiCad image's own user cannot write the runner's files, so
    checkout failed; the container now runs as root.
2026-11-10 test: Cover what the ratchet found untested since 2026-11-04
    The ratchet had not run since 2026-11-04, and coverage had slipped. New
    tests reach a phrase file with a language that holds no lists, a switch
    the controller never received, the names of the manual-off and
    not-armed refusals, and a wire check that falls inside a burst.
    [door_logic_test.cpp, test_phrases.py, test_server.py, wire_speed_test.cpp]
2026-11-10 chore: Record the quality levels as they are now
    quality.json had not been updated since 2026-11-04. Coverage, firmware
    coverage and complexity are back at or above their recorded levels.
    Duplication rose from 0 to 0.53 %: ManualPress and Switches take the same
    six keyword arguments in their constructors. Sharing them would tie two
    safety classes together for six lines, so the copy stays.
    Ratchet-Exception: duplication - two safety classes share constructor keywords
2026-11-10 ci: Give the KiCad job the standard symbol libraries
    Run as root, the KiCad container has no symbol library table, so the
    rule check reported nine missing libraries. The job now copies KiCad's
    own table first, as a fresh install does. Checked in the same image
    locally: no violations, and the netlist matches the plan.
2026-11-10 ci: Let main keep the quality levels, so no pull request records them
    Every pull request had to record the exact levels it reached in
    quality.json. Each new test changed the recorded count, so merging one
    open pull request broke the others. That is rule 16 of the shared
    voice-plugin standard, done as claude-voice did in ADR-CV-009.
    After every push to main, CI now measures the levels and keeps them with
    the run as the quality-levels artifact. A pull request compares with the
    levels main kept for its base and fails only when one is worse, unless a
    Ratchet-Exception line says why. When the levels are missing, the base
    is measured in a copy of it. quality.json keeps only the time budget,
    and r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
    [ratchet.py, test_ratchet.py]
2026-11-10 build: Run the quality ratchet in the local check
    The ratchet ran only in CI, and CI did not run while the repository was
    private. Quality slipped from 2026-11-04 to 2026-11-10 without anyone
    seeing it. just check now runs the ratchet against main, keeping the
    mutation figures the mutate step has just checked. This is rule 14 of the
    shared voice-plugin standard.
    [test_ratchet.py]
2026-11-10 feat: Mark the status tool as read-only
    The shared voice-plugin standard (claude-voice docs/plugin-standard.md,
    rule 9) asks a tool that changes nothing to carry readOnlyHint, so the
    bridge and the app can tell it from the ones that press or switch.
    garage_status now does, and a test checks that it is the only one.
2026-11-10 test: Hold each garage tool's longest wait to the voice's time
    The Claude app gives up on a tool after about 15 seconds. When that
    happens, the voice hears only "MCP tool call failed". A new test adds
    up each tool's longest path from the waits in the code. It checks that
    the path leaves room inside that limit, in the shape of tv-mcp's test.
    Three paths run over and are marked as known defects. A press or a
    magic phrase waits up to 31 s for the door, so a close that reverses
    would reach the voice as a failure instead of its warning. A controller
    off the network is not bounded at all; aioesphomeapi waits up to 60 s
    to connect. Their marks come off when the waits are cut. That needs
    Roy's deci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
    [test_voice_time_limit.py]
2026-11-10 feat: Answer a press within the voice's time, saying when not yet confirmed
    A press waited up to 30 s for the door. The voice gives a tool about 15 s,
    so the answer could be cut off, hiding whether a closing door closed.
    The wait is now at most 9 s (REPLY_SECONDS). With 3 s to connect, one more
    read and 2 s to spare, that fits in 15 s. A door still moving then is "not
    yet confirmed", with "ask me for its status in half a minute". A close
    adds that it may have reversed. A door that stopped short is reported as
    before. The press itself is unchanged, and nothing is pressed again.
    Roy chose this on 2026-11-10, through the claude-voice session. The two
    press paths in the time-limit test lose th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
    [test_service.py, test_simulator.py, test_voice_time_limit.py]
2026-11-10 fix: Give up on an unreachable controller after 5 seconds
    Off the network, aioesphomeapi waits 60 s to connect. The voice gives a
    tool about 15 s, so it heard only "MCP tool call failed".
    Connecting now gives up after 5 s (connect_wait), and the call fails
    closed: "not reachable", nothing pressed. The half-made client is dropped,
    so the next call starts afresh.
    [test_esphome_device.py]
2026-11-10 fix: Count the wait after a press from the yes, not from the press
    If the connection dropped between the question and the yes, reconnecting
    took up to 8 s before the press, and the 9 s wait came on top of it.
    The answer is now due 9 s after the yes, so reconnecting comes out of the
    wait. The time-limit test counts the connect on every path, and the last
    known-defect mark, the controller off the network, is gone.
    [test_service.py, test_voice_time_limit.py]
2026-11-10 fix: Say when the opener last reported its light, not its age
    The status gave light_age_s, the age of the opener's last status. The voice
    read it as "the light has been off for about three minutes", which was
    wrong: the opener repeats its status about every 5 minutes.
    The field is now light_reported_s_ago, and garage_status says it in a
    sentence: "the light was off at the opener's last report, 2 minutes ago".
    The voice page says what the age means and that "on" can be 5 minutes old.
    [test_manual.py, test_server.py]
2026-11-10 test: Pin where each controller reading lands, before splitting the code
    Each state from the controller must land only where its entity and type
    say: the door, the switches, the light and the status age, and nothing
    for an entity that has no name. Also the lookup of entities and actions
    by name on connecting. All pass on the code as it is.
2026-11-10 refactor: Split connecting to the controller and reading its states
    Connecting was one function of complexity 16, and reading a state 15.
    Now connecting is three steps (connect, learn the names, wait for the
    first state) and each kind of reading has its own handler. The most
    tangled function in the module is now 5. Nothing it does has changed;
    the tests from the commit before pin it.
2026-11-13 fix: Say "not reachable" when a switch command finds the link gone
    The link to the controller can drop after the last read and before arming
    or switching manual mode. aioesphomeapi then raises from switch_command,
    and nothing caught it. The voice heard a bare tool failure.
    The switch command now fails closed like a press does. It marks the link
    for reconnecting and raises DeviceUnavailableError, which the voice hears
    as "not reachable". Found by the claude-voice fake-limits sweep.
    [test_esphome_device.py]
2026-11-13 fix: Say a press the controller refused as refused, not as pressed
    The firmware judges every press itself. It refuses one within 2 s of the
    last, while a press runs, and when manual mode has timed out. Its verdict
    goes to the "Last press result" sensor, but the laptop never read it. It
    answered "sent", and a refused manual press was read aloud as "Pressed".
    The laptop now waits up to a second for the verdict published after the
    press. ESPHome sends every publish, so a repeated "accepted" still counts.
    A refusal is said as "The controller refused the press: <reason>." and is
    logged as refused. With no verdict in time, an open or close is judged by
    the door as before. A manual press then says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
    [test_esphome_device.py, test_manual.py, test_server.py, test_service.py]
2026-11-13 fix: Wait for the resent verdict before pressing on a new link
    On connecting, ESPHome sends every entity's state again. That includes
    "Last press result" with the previous press's verdict, a moment after the
    door's state. A press sent at once could take that old verdict as its own.
    An old refusal then stopped the watch on a door that may be moving.
    A fresh connection now also waits for the verdict sensor's state, which
    comes as missing when nothing was pressed since boot. Only then does it
    count as connected. A missing state is not shown as a reading. Found by
    the quality review of #24.
    [test_esphome_device.py]
2026-11-13 fix: Say what to do next after each refusal the controller gives
    A refused press said only the firmware's reason, with nothing to do next.
    garage-door#22 requires every refusal to end with a next step, and its
    check would fail on whichever pull request merged second.
    Each firmware reason now has its own words and next step, for a press
    and for a manual press. A reason not in the table falls back to "Look at
    the door". A test keeps the tables equal to door_logic.h's refusals.
    A manual press with no verdict now ends "Look at the door before you ask
    again.". A second manual press would reverse the door. From the quality
    review of #24.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
    [test_manual.py, test_service.py]
2026-11-13 fix: Keep a press answer in the voice's time when the link drops
    A read in the wait after a press could reconnect for up to 8 s past the
    reply. The report every answer carries could reconnect for 8 s more. A
    link that dropped in the wait could stretch the answer to about 25 s,
    and the voice cuts a tool off at 15.
    Each read in the wait is now bounded by the time left before the reply,
    and none starts after it. A read cut short counts as unknown. The report
    after an action gets 2 s, then reads as unknown. The worst case is now
    9 + 1 + 2 = 12 s. Found by the claude-voice fake-limits sweep.
    [test_server.py, test_service.py, test_voice_time_limit.py]
2026-11-13 fix: Drop a half-made connection when a read's time limit cuts it
    The service and the report now bound their reads, so a read can be
    cancelled while it connects. The CancelledError skipped the cleanup,
    which ran only for connection failures. The next press then reused the
    half-made client and could say "not reachable" for no reason. The
    controller kept the abandoned connection's slot.
    A cancelled connect now drops the client, shielded from the cancel, and
    re-raises. The next call builds a new client. From the quality review
    of #25.
    [test_esphome_device.py]
2026-11-13 fix: Say a refused key as a refused key, not as "not reachable"
    A controller flashed with another key answers on the network but refuses
    the handshake. The laptop said "not reachable", which sends Roy to check
    power and Wi-Fi when the fault is the key.
    The library's key errors now raise WrongKeyError. It is a kind of
    DeviceUnavailableError, so everything still fails closed. An open or
    close request, a confirm and switching on now say the controller refused
    the laptop's key, and to check that it was flashed with the key in
    firmware/secrets.yaml. The status and the manual press still read it as
    unknown. Found by the claude-voice fake-limits sweep.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
    [test_esphome_device.py, test_manual.py, test_service.py, test_switches.py]
2026-11-14 ci: Remove the time limit on the ratchet job
    The ratchet job measured the base and this change under a 25-minute
    limit. The ratchet grows with every rule, and a run cut short at the
    limit proves nothing about whether a level got worse. Roy's rule is that
    mutation and ratchet runs are never capped.
    The job now has no limit, with a comment saying why, so the next person
    removes a cap rather than raises it. The other jobs keep theirs.
2026-11-14 fix: Leave no temporary files behind after test and mutation runs
    On 2026-11-14 /tmp ran out of inodes. About 756k of 1M sat under
    /tmp/pytest-of-roy, left by test and mutation runs. No program could
    start a command. This brings the bridge's fix (claude-voice #269) here.
    pytest now deletes a passing test's temporary files at once. It keeps
    only the latest run's failures. scripts/mutate.py gives each suite run
    a folder of its own and removes it when the run ends. That works even
    where a test took away the rights to read or delete it. The folder is
    outside the checkout: inside it, a test that makes a git repository
    would find this one. A link is never followed, so what it points to
    keeps its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
    [mutate.py, test_mutation_temp_files.py]
2026-11-14 fix: Say what to do next in every refusal the garage door gives
    The garage door plugin refuses a press, a switch or a confirmation
    whenever anything is uncertain. Many refusals said only what was wrong,
    such as "The garage door controller is not reachable." That left Roy
    with nothing to do.
    Every refusal now ends with a next step. An unreachable controller says
    to check its power and Wi-Fi, then ask for the status again. A
    controller that is not armed says to arm it on the laptop, as the README
    shows. No refusal asks the voice to arm it. When or whether the door is
    pressed does not change.
    No refusal names a laptop command either. The command is not on the
    PATH, and it needs the controller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
    [test_next_step.py, test_server.py, test_service.py]
2026-11-14 fix: Say a missing key as a key fault, not as "not reachable"
    A laptop with no key set talks to a controller that wants one. The
    controller answers, so it is not off the network. The library raises
    RequiresEncryptionAPIError, a kind of connection error, so it was said
    as "not reachable" and sent Roy to check power and Wi-Fi. It is now one
    of the key failures. The voice says the controller refused the laptop's
    key and points to the key in firmware/secrets.yaml.
    To keep the module under 300 lines, the two switch setters share the
    "no such switch" check in `_switch`. Two lines are also tightened. None
    of this changes what is said or done.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
    [test_esphome_device.py]
